boomshanka/Studienarbeit/doku/oszi/15-05-11/README

11. Mai 15: Auswertung Signale von Empfänger (Endplatine)

1: Erster OP, verstärkt Signal mit Faktor ~100
2: Ausgang und Eingang, Tiefpasswirkung und hohe Verstärkung wird sichtbar
