boomshanka/Studienarbeit/doku/oszi/15-04-16/README.txt

1: Laufzeitmessung. Channel 2 ist Sender, Channel 1 das empfangene Signal (hinter Transistor)
2: Signal von Push-Pull Ausgangsstufe. Zu schmal und Low-Pegel wird nicht sauber gehalten. Erster Puls ist doppelt so lang wie sein sollte.
3: Selbes Signal, erster Puls nicht verdoppelt.
4: Prototyp-Platine von unten
