boomshanka/Studienarbeit/doku/content/02_uebersicht.tex

%!TEX root = ../dokumentation.tex

% Kapitel als Übersicht des Projekts
% Inhalt: Zielsetzung, Entiwcklung/Umsetzung, Hardware, Architektur, Tools

\chapter{Projektübersicht}

%\section{Ziel}
Das Ziel des Projektes ist es, die Position eines Objektes mithilfe von Ultraschallsensoren zu messen. Dabei reicht die Position auf einer Fläche, sie muss daher nur zweidimensional bestimmt werden. Das Ergebnis soll anschließend auf einem Bildschirm visualisiert werden.\\
Ein erstes Zwischenergebnis sollte mit der Abstandsmessung einer einzelnen Sensorplatine erreicht werden. Diese Aufgabe umfasst bereits alle physikalische Prinzipien, die zur Positionsbestimmung genutzt werden. Die Ergebnisse der Messungen können daraufhin verwendet werden, um mögliche Probleme zu beseitigen und die Schaltungen zu optimieren. Sobald die Abstandsmessung zuverlässig funktioniert, kann das endgültige System darauf aufgebaut werden, sodass weitere Probleme ausschließlich durch die Architektur der Lösung hervorgerufen werden können und deshalb einfach zu identifizieren sind.

\section{Architektur} % Hier wird auch die Hardware beschrieben
Für die Positionsbestimmung werden drei Sender und Empfänger verwendet, sodass nicht nur die Position, sondern auch die Größe des Objekts bestimmbar ist. Jeweils einer ist auf einer Platine verbaut, auf der sich zusätzlich Schaltungen für die Signalverarbeitung und ein Mikrocontroller befinden. Die drei Platinen werden so angeordnet, dass sie Objekte in ihrer Mitte erkennen können. Sie sind mit einem Einplatinen-Computer verbunden, mit dem die Mikrocontroller über einen \ac{TWI}-Bus kommunizieren können. Zwischen dem Computer und den Sensorplatinen befindet sich eine Verteiler-Platine, an der die Stromversorgung eingesteckt wird und die Leitungen von Computer zu Platinen entsprechend verkabelt sind.
Zur Verbindung untereinander werden Flachbandkabel verwendet. Die Verteiler-Platine besitzt zusätzlich einen Steckplatz mit einer Standard-\ac{ISP}-Pinbelegung, mit dem die Mikrocontroller direkt vom Einplatinen-Computer beschrieben werden können.\\
% Bild Architektursübersicht
\begin{figure}[H]
\centering
\begin{tikzpicture}
%\filldraw[fill=black!20, draw=black] (0,0) -- (10,0) -- (10,5) -- (0,5) -- (0,0);

% Positionen der Platinen
\coordinate (s1) at (0, 0);
\coordinate (s2) at (3.3, 5.2);
\coordinate (s3) at (-3.3, 5.2);
\coordinate (com) at (-6.5, -1);
\coordinate (dis) at (-7, 3);
\coordinate (ver) at (-4, -1);
\coordinate (ob) at (-0.5, 3.5);

% Verbindungen
% Computer-Verteiler
\draw (com) -- (ver);
% Verteiler-Sensor1
\draw (ver) -- (0,-1);
% Verteiler-Sensor2
\draw (ver) |- (0,-1.7) -| ($(s2) + (1,0)$);
% Verteiler-Sensor3
\draw (ver) |- (s3);
% Computer-Bildschirm
\draw (com) |- ($(dis) + (0,-1.1)$);

% Platine 1
\begin{scope}[shift=(s1), rotate around={180:(s1)}]
	\filldraw[fill=red!60!black, draw=black] (-0.5,0) rectangle (0.5, 1.5);
	\fill[fill=black!80, draw=black] (0.15, 0) ellipse (0.12 and 0.08);
	\fill[fill=black!80, draw=black] (-0.15, 0) ellipse (0.12 and 0.08);
	\node[right] at (-0.7,1) {Sensorplatine 1};
\end{scope}

% Platine 2
\begin{scope}[shift=(s2), rotate around={300:(s2)}]
	\filldraw[fill=red!60!black, draw=black] (-0.5,0) rectangle (0.5, 1.5);
	\fill[fill=black!80, draw=black] (0.15, 0) ellipse (0.12 and 0.08);
		\fill[fill=black!80, draw=black] (-0.15, 0) ellipse (0.12 and 0.08);
	\node at (0, 3) {Sensorplatine 2};
\end{scope}

% Platine 3
\begin{scope}[shift=(s3), rotate around={60:(s3)}]
	\filldraw[fill=red!60!black, draw=black] (-0.5,0) rectangle (0.5, 1.5);
	\fill[fill=black!80, draw=black] (0.15, 0) ellipse (0.12 and 0.08);
		\fill[fill=black!80, draw=black] (-0.15, 0) ellipse (0.12 and 0.08);
	\node at (0, 3) {Sensorplatine 3};
\end{scope}

% Objekt
\filldraw[fill=green!50, draw=black] (ob) circle (0.7);
\node at (ob) {Objekt};

% Verteilerplatine
\begin{scope}[shift=(ver)]
	\filldraw[fill=brown!70, draw=black] (-0.25, -0.5) rectangle (0.25, 0.5);
	\node[below right] at (0, -0.7) {Verteilerplatine};
\end{scope}

% Raspberry PI
\begin{scope}[shift=(com)]
	\filldraw[fill=blue!70!black!70!white, draw=black] (-0.5, -0.75) rectangle (0.5, 0.75);
	\node[below] at (0, -0.75) {Computer};
\end{scope}

% Bildschirm
\begin{scope}[shift=(dis)]
	\filldraw[fill=white!70!black, draw=black] (-0.15, 0) rectangle (0.15, -1.4);
	\filldraw[fill=white!70!black, draw=black] (-1, -0.8) rectangle (1, 0.8);
	\filldraw[fill=white, draw=black] (-0.8, -0.6) rectangle (0.8, 0.6);
	\node[above] at (0, 0.9) {Bildschirm};
\end{scope}

\end{tikzpicture}
\caption{Schema der Architektur} \label{fig:ARCH}
\end{figure}

\subsection{Mikrocontroller}
Die Mikrocontroller auf den Sensorplatinen erfüllen folgende Zwecke:
\begin{itemize}
	\item Ansteuerung der Ultraschallsender
	\item Signal am Empfänger detektieren
	\item Laufzeitmessung durchführen
	\item Status über LEDs anzeigen
	\item Schnittstelle nach außen über das \ac{TWI} bereitstellen
\end{itemize}
Verwendet wird dafür der AVR-Mikrocontroller \textit{ATmega8} von Atmel. Die Controller aus der AVR-Familie sind weit verbreitet und besitzen eine 8-Bit Architektur mit einem \ac{RISC}-Befehlssatz. Sie sind günstig, einfach zu handhaben, besitzen eine übersichtliche innere Struktur und es gibt eine Vielzahl an Software und Tools, um mit ihnen zu arbeiten. Die Mikrocontroller bieten neben einfachen digitalen Input-/Output-Pins auch zusätzliche Hardwarefunktionen, wie z.B. Analog-Digital-Wandler, \ac{TWI}- und andere serielle Schnittstellen, Timer, verschiedenste Hardware-Interrupts und vieles mehr. \cite{datasheet:atmega}\\
Das Programm für die oben genannten Funktionen läuft als Firmware direkt auf der Hardware und ist in C geschrieben.

\subsection{Computer}
Der Einplatinen-Computer hat folgende Aufgaben:
\begin{itemize}
	\item Das Timing der Messungen kontrollieren
	\item Messergebnisse sammeln und auswerten
	\item Berechnete Position darstellen
	\item Eine \ac{GUI} bereitstellen %TODO: Ein/Eine?
\end{itemize}
Für diesen Zweck wird ein \textit{Raspberry PI} verwendet. Er besitzt ein \ac{GPIO}-Interface, mit dem die Mikrocontroller gesteuert werden können, sowie ein \ac{HDMI}-Ausgang für die Visualisierung auf einem Bildschirm. Auf dem Computer läuft das Betriebssystem \textit{Archlinux}, welches speziell für die mobilen \textit{ARM}-Prozessoren angepasst wurde.\footnote{\url{http://archlinuxarm.org/}}

\section{Entwicklung}
Es gibt bereits eine Vielzahl von fertigen Ultraschallmodulen zu kaufen, die mit relativ wenig Aufwand ansteuerbar und verwendbar sind. In diesem Projekt werden jedoch einfache Ultraschall-Sender und -Empfänger verwendet, sodass die dazugehörigen Schaltungen selbst erstellt werden konnten. Zudem mussten weitere Komponenten entwickelt werden, um das gesamte System lauffähig zu machen:
\begin{description}
	\item[Die Sensorplatine] mit den Komponenten:
	\begin{itemize}
		\item Sendeverstärker-Schaltung.
		\item Empfängerschaltung.
		\item Firmware für den Mikrocontroller.
	\end{itemize}
	\item[Die Verteilerplatine] mit den Komponenten:
	\begin{itemize}
		\item Bidirektionale \ac{TWI}-Spannungswandlung zwischen $3.3V$ (Raspberry Pi) und $5V$ (AVR-Mikrocontroller).
		\item Die \ac{ISP}-Schnittstelle.
		\item Verkabelung und Stromversorgung.
	\end{itemize}
	\item[Die Schnittstelle] zwischen Controllern und Computer:
	\begin{itemize}
		\item Das Protokoll, das auf dem \ac{TWI} aufsetzt.
		\item Implementierung des Interfaces in der Firmware und auf dem Computer.
	\end{itemize}
	\item[Die Software] für den Raspberry Pi:
	\begin{itemize}
		\item Die grafische Oberfläche.
		\item Ansteuerung der Platinen.
		\item Ablauf und Timing der Messungen.
	\end{itemize}
\end{description}

\section{Verwendete Tools}
Für die Entwicklung der Schaltungen sind einige Programme zum Einsatz gekommen. Damit lassen sich die Funktionalität überprüfen, Frequenzgänge berechnen und es können Platinenentwürfe und Schaltpläne entworfen werden. Die wichtigsten Tools für dieses Projekt waren folgende:
\begin{description}
	\item[KiCAD] ist ein open-source Programm, mit dem modulare Schaltpläne gezeichnet werden können, woraus sich anschließend CAD-Modelle einer Platine erstellen lassen. Das Programm wird maßgeblich am \textit{CERN} entwickelt und unterstützt viele zusätzliche Funktionen. So kann z.B. eine Netzliste für die \textit{SPICE}-Engine erstellt werden, mit der die Schaltungen simuliert werden können.\footnote{\url{http://www.kicad-pcb.org/}}
	\item[LTspice] ist ein Tool von \textit{Linear Technology} um analoge und digitale Schaltungen zu simulieren, insbesondere mit den firmeneigenen Operationsverstärkern. Das Programm basiert auf dem Simulator \textit{SPICE} und besitzt einen eigenen Schaltungseditor.\footnote{\url{http://www.linear.com/designtools/software/\#LTspice}}
	\item[AktivFilter] ist ein Tool, um Frequenzfilter mit Operationsverstärkern zu entwerfen. Aus einigen Vorgaben berechnet das Programm ein Bode-Diagramm, dimensioniert die Bauteile und stellt einen Schaltplan zur Verfügung.\footnote{\url{http://www.softwaredidaktik.de/filter/}}
\end{description}
