boomshanka/Studienarbeit/doku/ads/deckblatt.tex

%!TEX root = ../dokumentation.tex

\begin{titlepage}
	\begin{longtable}{p{8.2cm} p{5.4cm}}
%		{\raisebox{\ht\strutbox-\totalheight}{\includegraphics{images/firma-deckblatt.png}}} &
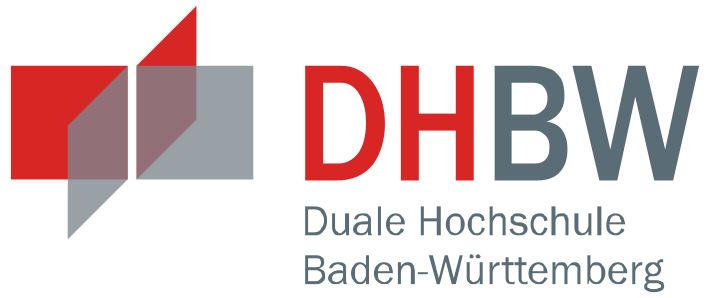
[picture p21: doku/images/dhbw.png]
		{\raisebox{\ht\strutbox-\totalheight}{}}
	\end{longtable}
	\enlargethispage{20mm}
	\begin{center}
		\vspace*{12mm}	{\LARGE\bf \titel }\\
		\vspace*{12mm}	{\large\bf \arbeit}\\
		\vspace*{12mm}	\langdeckblattabschlusshinleitung\\
		\vspace*{3mm}		{\bf \abschluss}\\
    \vspace*{12mm}	\langartikelstudiengang{} \studiengang\\
    \vspace*{3mm}		\langanderdh{} \dhbw\\
		\vspace*{12mm}	\langvon\\
		\vspace*{3mm}		{\large\bf \autor}\\
		\vspace*{12mm}	\datumAbgabe\\
	\end{center}
	\vfill
	\begin{spacing}{1.2}
	\begin{tabbing}
		mmmmmmmmmmmmmmmmmmmmmmmmmm             \= \kill
%		\textbf{\langdbbearbeitungszeit}       \>  \zeitraum\\
		\textbf{\langdbkurs}  \>  \kurs\\
%		\textbf{\langdbfirma}                  \>  \firma, \firmenort\\
		\textbf{\langdbgutachter, \langdbbetreuer}               \>  \betreuer\\
%		\textbf{\langdbgutachter}              \>  \gutachter
	\end{tabbing}
	\end{spacing}
\end{titlepage}
