boomshanka/Studienarbeit/doku/ads/erklaerung.tex

%!TEX root = ../dokumentation.tex

\thispagestyle{empty}

\section*{\langerklaerung}
% http://www.se.dhbw-mannheim.de/fileadmin/ms/wi/dl_swm/dhbw-ma-wi-organisation-bewertung-bachelorarbeit-v2-00.pdf
\vspace*{2em}

\iflang{de}{%
Wir erklären hiermit ehrenwörtlich: \\
\begin{enumerate}
\item dass wir unsere {\arbeit} mit dem Thema
{\itshape \titel } ohne fremde Hilfe angefertigt haben;
\item dass wir die Übernahme wörtlicher Zitate aus der Literatur sowie die Verwendung der Gedanken
anderer Autoren an den entsprechenden Stellen innerhalb der Arbeit gekennzeichnet haben;
\item dass wir unsere {\arbeit} bei keiner anderen Prüfung vorgelegt haben;
\item dass die eingereichte elektronische Fassung exakt mit der eingereichten schriftlichen Fassung
übereinstimmt.
\end{enumerate}

Wir sind uns bewusst, dass eine falsche Erklärung rechtliche Folgen haben wird.
}

\iflang{en}{%
Unless otherwise indicated in the text or references, or acknowledged
above, this thesis is entirely the product of my own scholarly work. This
thesis has not been submitted either in whole or part, for a degree at this
or any other university or institution. This is to certify that the printed
version is equivalent to the submitted electronic one.
}

\vspace{3em}

\abgabeort, \datumAbgabe
\vspace{4em}

\autor
