boomshanka/Studienarbeit/doku/oszi/15-04-30/README

1: Ansteuersignal und Ausgang der Gegentaktstufe (mit angeschlossenen Sender). Flanken gut, Oberwellen sichtbar. Besser gehts nicht mehr..
