boomshanka/Studienarbeit/doku/dokumentation.tex

%%**************************************************************
%% Vorlage fuer Bachelorarbeiten (o.ä.) der DHBW
%%
%% Autor: Tobias Dreher, Yves Fischer
%% Datum: 06.07.2011
%%
%% Autor: Michael Gruben
%% Datum: 15.05.2013
%%
%% Autor: Markus Barthel
%% Datum: 22.08.2014
%%**************************************************************

\input{ads/header}

\makeglossaries
\input{ads/glossary}

\begin{document}

	% Deckblatt
	\begin{spacing}{1}
		\input{ads/deckblatt}
	\end{spacing}
	\newpage

	\renewcommand{\thepage}{\Roman{page}}
	\setcounter{page}{1}

	% Sperrvermerk
%	\input{ads/sperrvermerk}
%	\newpage

	% Erklärung
	\input{ads/erklaerung}
	\newpage

	% Abstract
%	\input{ads/abstract}
%	\newpage

	\pagestyle{plain}

	% Inhaltsverzeichnis
	\begin{spacing}{1.1}
		\setcounter{tocdepth}{1}
		%für die Anzeige von Unterkapiteln im Inhaltsverzeichnis
		%\setcounter{tocdepth}{2}
		\tableofcontents
	\end{spacing}
	\newpage

	\renewcommand{\thepage}{\arabic{page}}
	\setcounter{page}{1}

	% Inhalt
	\input{content/01_einfuehrung.tex}
	\input{content/02_uebersicht.tex}
	\input{content/03_schaltungen.tex}
	\input{content/04_platinen.tex}
	\input{content/05_firmware.tex}
	\input{content/06_schnittstellenkommunikation.tex}
	\input{content/07_gui.tex}
%	\input{content/08_funktionstest.tex} % Messergebnisse, Genauigkeit, Zuverlässigkeit
	\input{content/09_inbetriebnahme.tex}
	\input{content/10_schluss.tex}

	% Anhang
	\clearpage
	\pagenumbering{roman}

	% Abbildungsverzeichnis
	\cleardoublepage
	\listoffigures

	%Tabellenverzeichnis
%	\cleardoublepage
%	\listoftables

	% Quellcodeverzeichnis
%	\cleardoublepage
%	\lstlistoflistings

	% Literaturverzeichnis
	\cleardoublepage
	\printbibliography

	% Abkürzungsverzeichnis
	\cleardoublepage
	\phantomsection \label{listofacs}
	\addcontentsline{toc}{chapter}{\langabkverz}
	\input{ads/acronyms}

	% Glossar
	\printglossary[style=altlist,title=\langglossar]
\end{document}
