boomshanka/Studienarbeit/doku/ads/header.tex

%!TEX root = ../dokumentation.tex

%
% Nahezu alle Einstellungen koennen hier getaetigt werden
%

\documentclass[%
	pdftex,
	oneside,			% Einseitiger Druck.
	12pt,				% Schriftgroesse
	parskip=half,		% Halbe Zeile Abstand zwischen Absätzen.
	headsepline,		% Linie nach Kopfzeile.
	footsepline,		% Linie vor Fusszeile.
	abstracton,			% Abstract Überschriften
	listof=totoc,
	toc=bibliography,
]{scrreprt}

% Einstellungen laden
\usepackage{xstring}
\usepackage[utf8]{inputenc}
\usepackage[T1]{fontenc}

\newcommand{\einstellung}[1]{%
  \expandafter\newcommand\csname #1\endcsname{}
  \expandafter\newcommand\csname setze#1\endcsname[1]{\expandafter\renewcommand\csname#1\endcsname{##1}}
}
\newcommand{\langstr}[1]{\einstellung{lang#1}}

\input{ads/einstellungen_liste} % verfügbare Einstellungen
\input{einstellungen} % lese Einstellungen

\input{lang/strings} % verfügbare Strings
\input{lang/\sprache} % Übersetzung einlesen

\usepackage[english, ngerman]{babel}
\iflang{de}{\selectlanguage{ngerman}} % Paket babel benutzt neue deutsche Rechtschreibung
\iflang{en}{\selectlanguage{english}} % Paket babel benutzt Englisch

%%%%%%% Package Includes %%%%%%%

\usepackage[margin=1in]{geometry}
\usepackage[activate]{microtype} %Zeilenumbruch und mehr
\usepackage[onehalfspacing]{setspace}
\usepackage{makeidx}
\usepackage[autostyle=true,german=quotes]{csquotes}
\usepackage{longtable}
\usepackage{graphicx}
\usepackage{xcolor} 	%xcolor für HTML-Notation
\usepackage{float}
\usepackage{array}
\usepackage{calc}		%zum Rechnen (Bildtabelle in Deckblatt)
\usepackage[right]{eurosym}
\usepackage{wrapfig}
\usepackage{pgffor} % für automatische Kapiteldateieinbindung
\usepackage[perpage, hang, multiple, stable]{footmisc}
\usepackage[printonlyused,footnote]{acronym}
\usepackage[nonumberlist,toc]{glossaries}
\usepackage{listings}

% eine Kommentarumgebung "k" (Handhabe mit \begin{k}<Kommentartext>\end{k},
% Kommentare werden rot gedruckt). Wird \% vor excludecomment{k} entfernt,
% werden keine Kommentare mehr gedruckt.
\usepackage{comment}
\specialcomment{k}{\begingroup\color{red}}{\endgroup}
%\excludecomment{k}

% TIKZ für Grafiken
\usepackage{tikz}
\usepackage{circuitikz}

\usetikzlibrary{calc}
\usetikzlibrary{shapes.geometric, arrows}

\tikzstyle{startstop} = [rectangle, rounded corners, minimum width=4.5cm, minimum height=1cm,text centered, draw=black, fill=red!30]
\tikzstyle{io} =		[trapezium, trapezium left angle=70, trapezium right angle=110, minimum width=4.5cm, minimum height=1cm, text centered, draw=black, fill=blue!30]
\tikzstyle{process} =	[rectangle, minimum width=4.5cm, minimum height=1cm, text centered, draw=black, fill=orange!30]
\tikzstyle{decision} =	[diamond, minimum width=4.5cm, minimum height=1cm, text centered, draw=black, fill=green!30]
\tikzstyle{arrow} =		[thick,->,>=stealth]

%%%%%% Configuration %%%%%

%% Anwenden der Einstellungen

\usepackage{\schriftart}
\ladefarben{}

% Titel, Autor und Datum
\title{\titel}
\author{\autor}
\date{\datum}

% PDF Einstellungen
\usepackage[%
	pdftitle={\titel},
	pdfauthor={\autor},
	pdfsubject={\arbeit},
	pdfcreator={pdflatex, LaTeX with KOMA-Script},
	pdfpagemode=UseOutlines, 		% Beim Oeffnen Inhaltsverzeichnis anzeigen
	pdfdisplaydoctitle=true, 		% Dokumenttitel statt Dateiname anzeigen.
	pdflang={\sprache}, 			% Sprache des Dokuments.
]{hyperref}

% (Farb-)einstellungen für die Links im PDF
\hypersetup{%
	colorlinks=true, 		% Aktivieren von farbigen Links im Dokument
	linkcolor=LinkColor, 	% Farbe festlegen
	citecolor=LinkColor,
	filecolor=LinkColor,
	menucolor=LinkColor,
	urlcolor=LinkColor,
	linktocpage=true, 		% Nicht der Text sondern die Seitenzahlen in Verzeichnissen klickbar
	bookmarksnumbered=true 	% Überschriftsnummerierung im PDF Inhalt anzeigen.
}
% Workaround um Fehler in Hyperref, muss hier stehen bleiben
\usepackage{bookmark} %nur ein latex-Durchlauf für die Aktualisierung von Verzeichnissen nötig

% Schriftart in Captions etwas kleiner
\addtokomafont{caption}{\small}

% Literaturverweise (sowohl deutsch als auch englisch)
\iflang{de}{%
\usepackage[
	backend=bibtex,		% empfohlen. Falls biber Probleme macht: bibtex
	bibwarn=true,
	bibencoding=utf8,	% wenn .bib in utf8, sonst ascii
	sortlocale=de_DE,
	style=numeric-comp	%Zitierstil. Siehe http://ctan.mirrorcatalogs.com/macros/latex/contrib/biblatex/doc/biblatex.pdf
]{biblatex}
}

\iflang{en}{%
\usepackage[
	backend=biber,		% empfohlen. Falls biber Probleme macht: bibtex
	bibwarn=true,
	bibencoding=utf8,	% wenn .bib in utf8, sonst ascii
	sortlocale=en_US,
	style=alphabetic	%Zitierstil. Siehe http://ctan.mirrorcatalogs.com/macros/latex/contrib/biblatex/doc/biblatex.pdf
]{biblatex}
}

\ladeliteratur{}

%%%%%% Additional settings %%%%%%

% Hurenkinder und Schusterjungen verhindern
% http://projekte.dante.de/DanteFAQ/Silbentrennung
\clubpenalty=10000
\widowpenalty=10000
\displaywidowpenalty=10000

% Bildpfad
\graphicspath{{images/}}

% Einige häufig verwendete Sprachen
\lstloadlanguages{PHP,Python,Java,C,C++,bash}
\listingsettings{}

\setlength{\tabcolsep}{\spaltenabstand}
\renewcommand{\arraystretch}{\zeilenabstand}

\usepackage{lscape}
