boomshanka/Studienarbeit/Datenblätter/PDIP.jpg

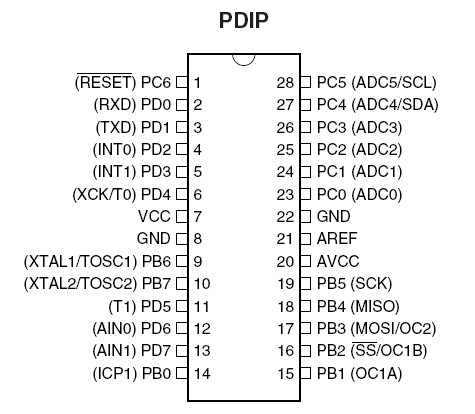
Datenblätter/PDIP.jpg
