boomshanka/Studienarbeit/doku/oszi/14-27-12/2_02.jpg

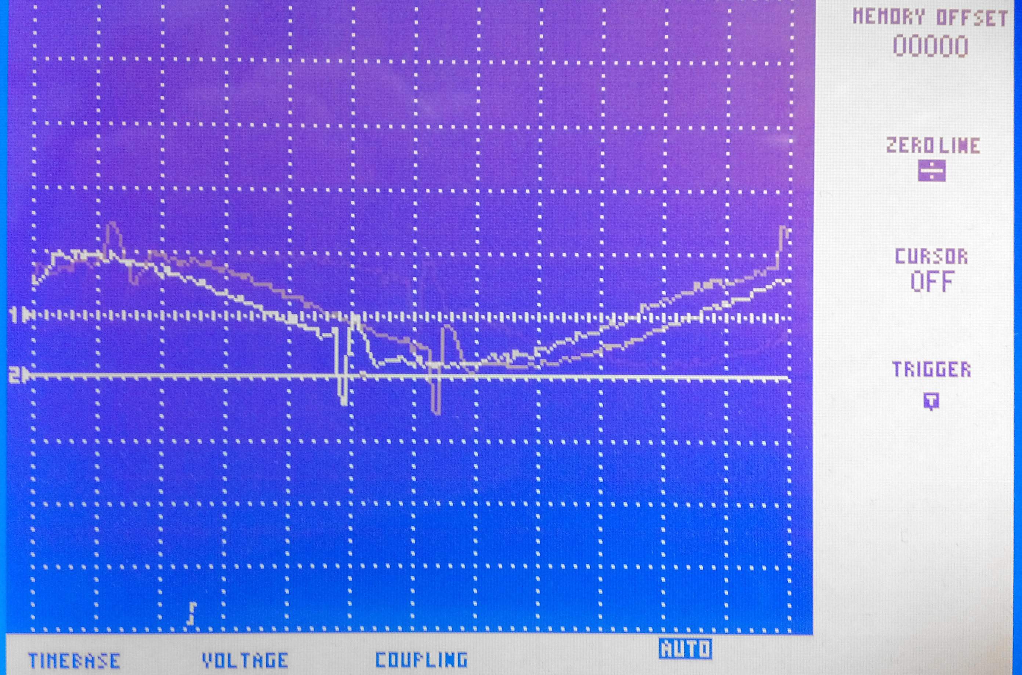
doku/oszi/14-27-12/2_02.jpg
