boomshanka/Studienarbeit/doku/oszi/15-04-01/1.jpg

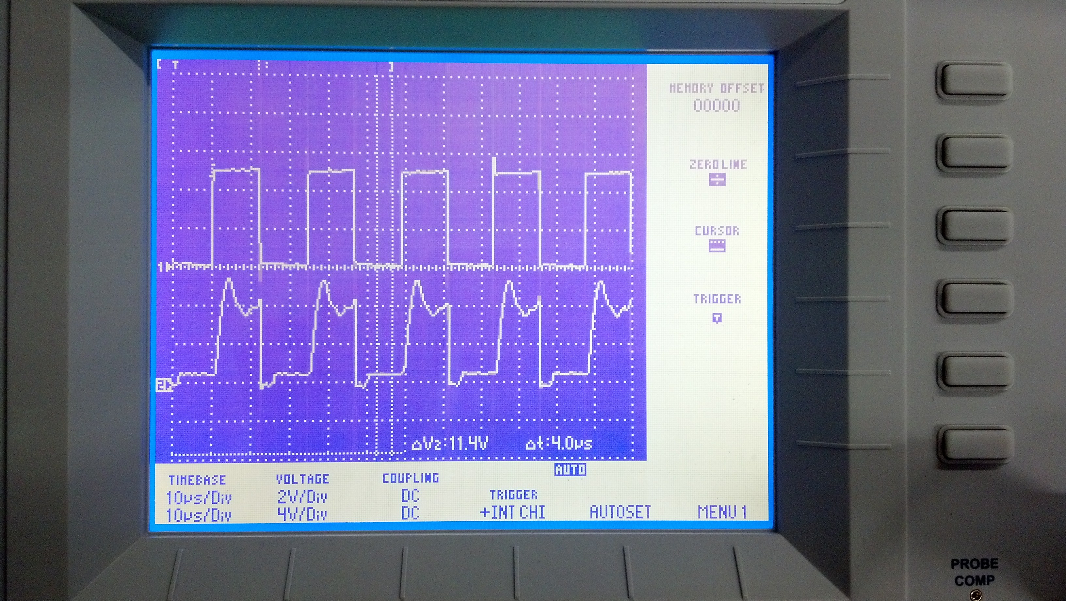
doku/oszi/15-04-01/1.jpg
