boomshanka/Studienarbeit/doku/oszi/15-04-01/1.png

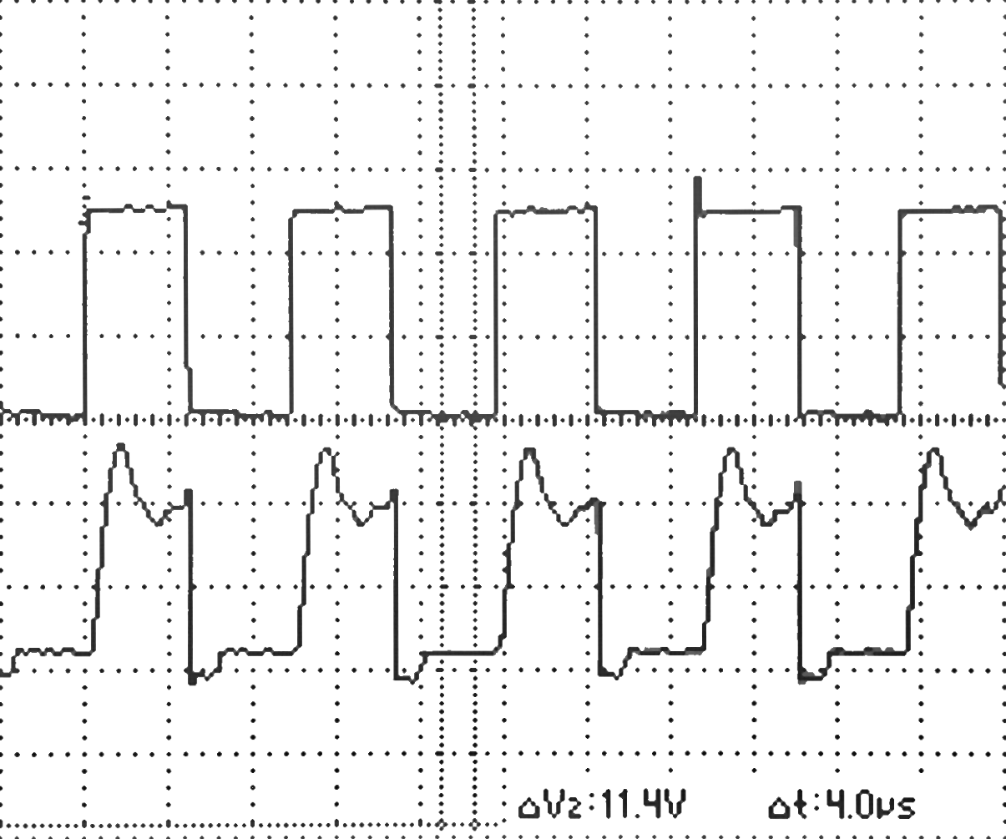
doku/oszi/15-04-01/1.png
