boomshanka/Studienarbeit/doku/oszi/15-04-01/2.jpg

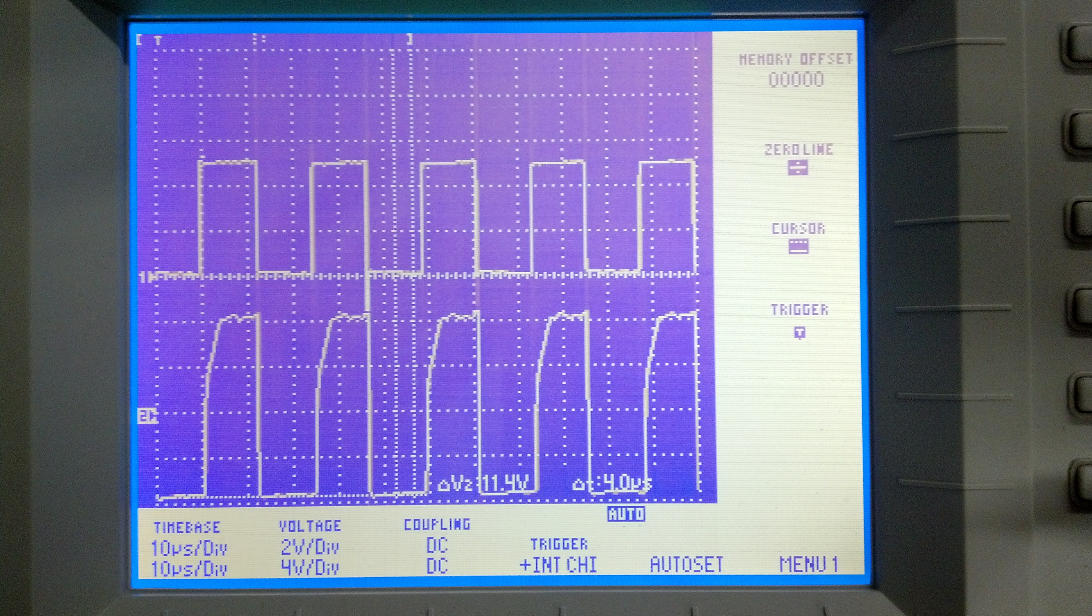
doku/oszi/15-04-01/2.jpg
