boomshanka/Studienarbeit/doku/oszi/15-04-01/2.png

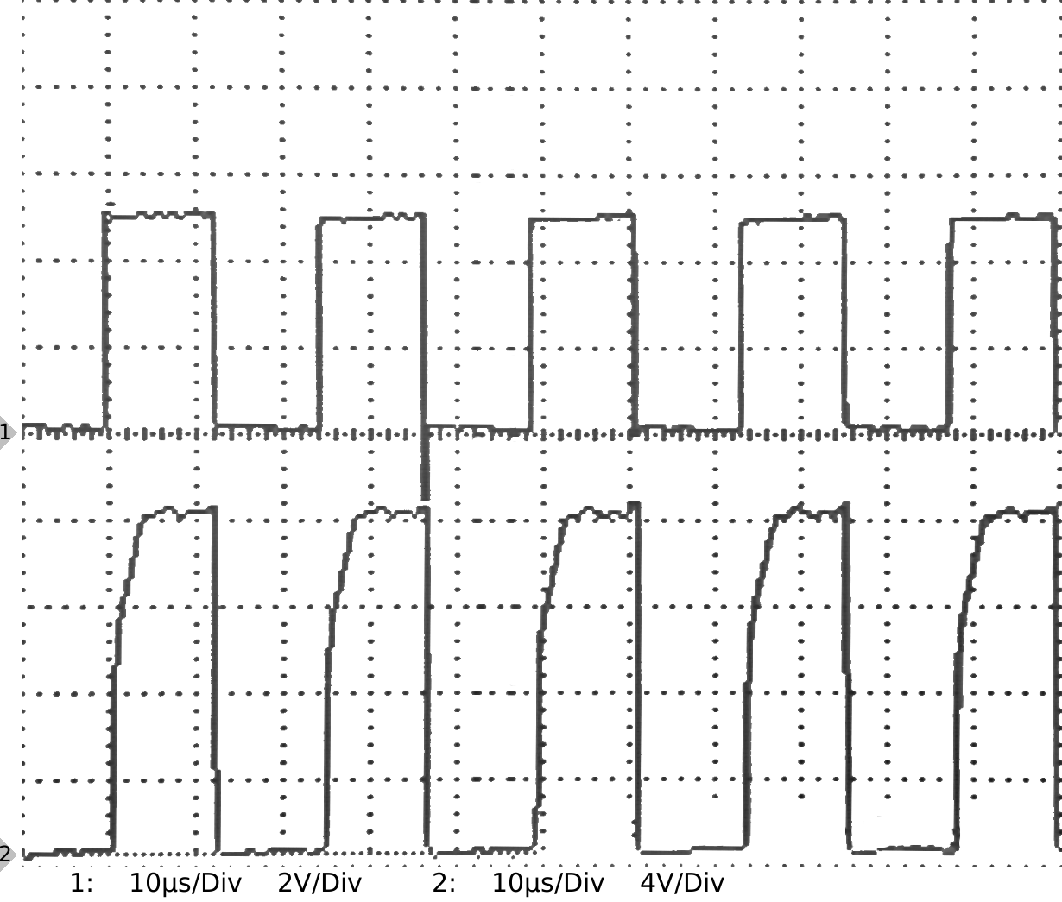
doku/oszi/15-04-01/2.png
