boomshanka/Studienarbeit/doku/oszi/15-04-01/3.jpg

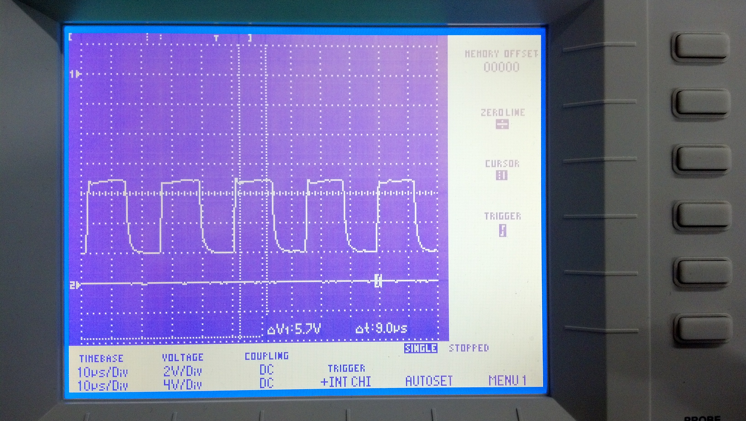
doku/oszi/15-04-01/3.jpg
