boomshanka/Studienarbeit/doku/oszi/15-04-01/3.png

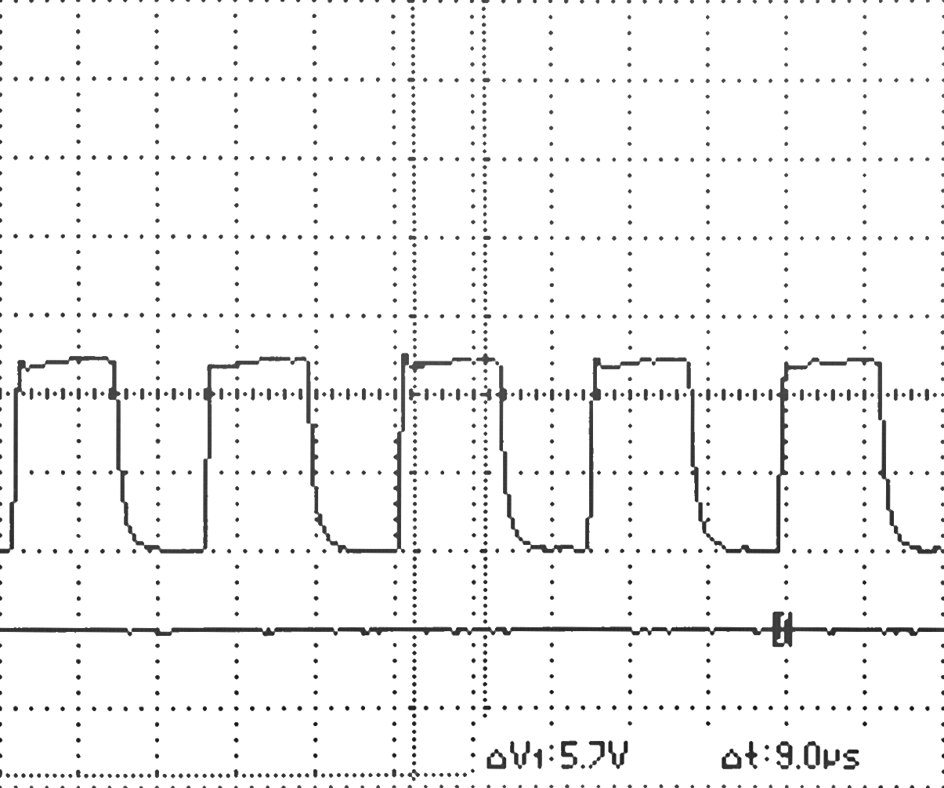
doku/oszi/15-04-01/3.png
