boomshanka/Studienarbeit/doku/oszi/15-04-01/4.jpg

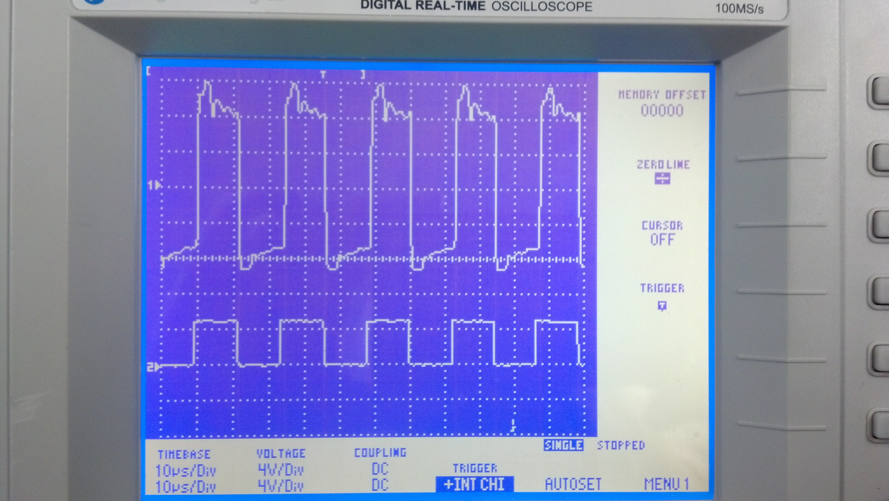
doku/oszi/15-04-01/4.jpg
