boomshanka/Studienarbeit/doku/oszi/15-04-16/1.jpg

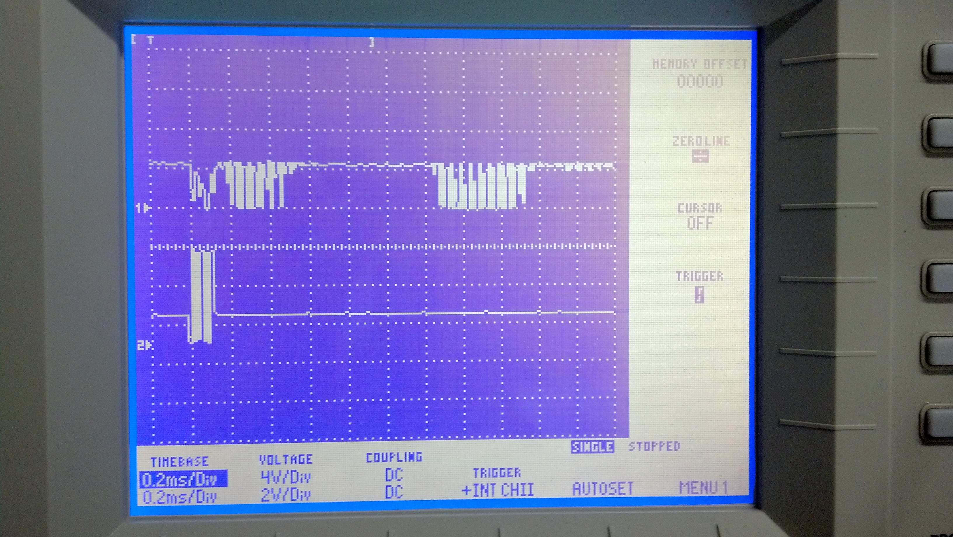
doku/oszi/15-04-16/1.jpg
