boomshanka/Studienarbeit/doku/oszi/15-04-16/1.png

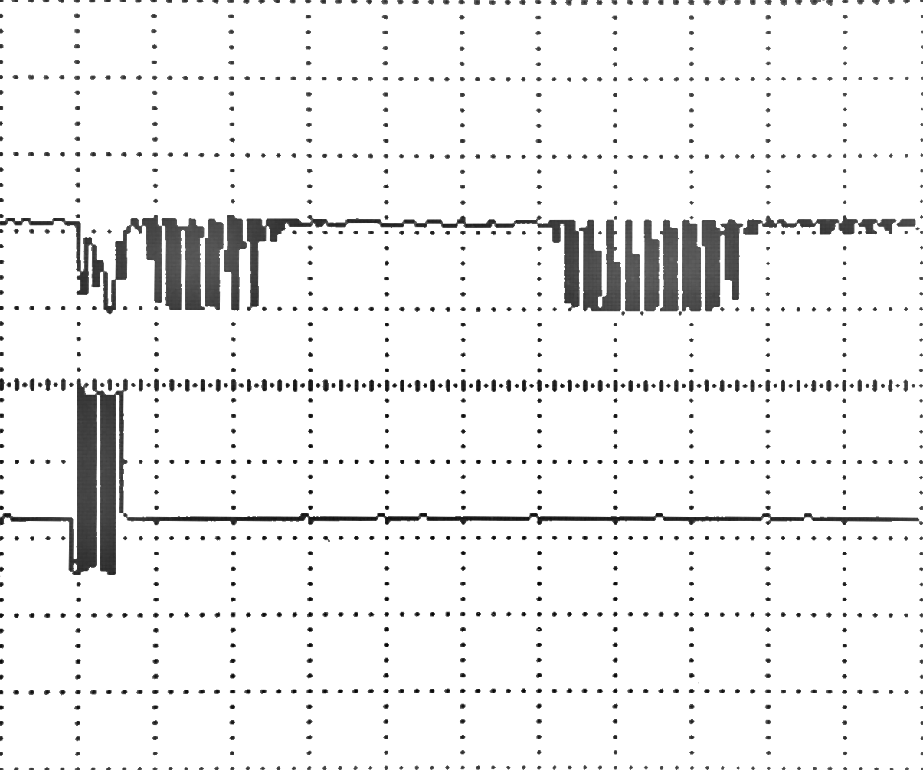
doku/oszi/15-04-16/1.png
