boomshanka/Studienarbeit/doku/oszi/15-04-16/2.jpg

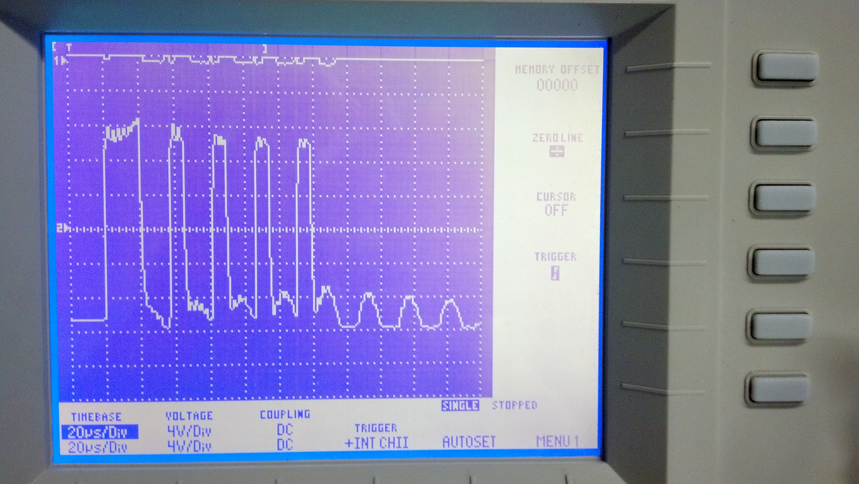
doku/oszi/15-04-16/2.jpg
