boomshanka/Studienarbeit/doku/oszi/15-04-16/2.png

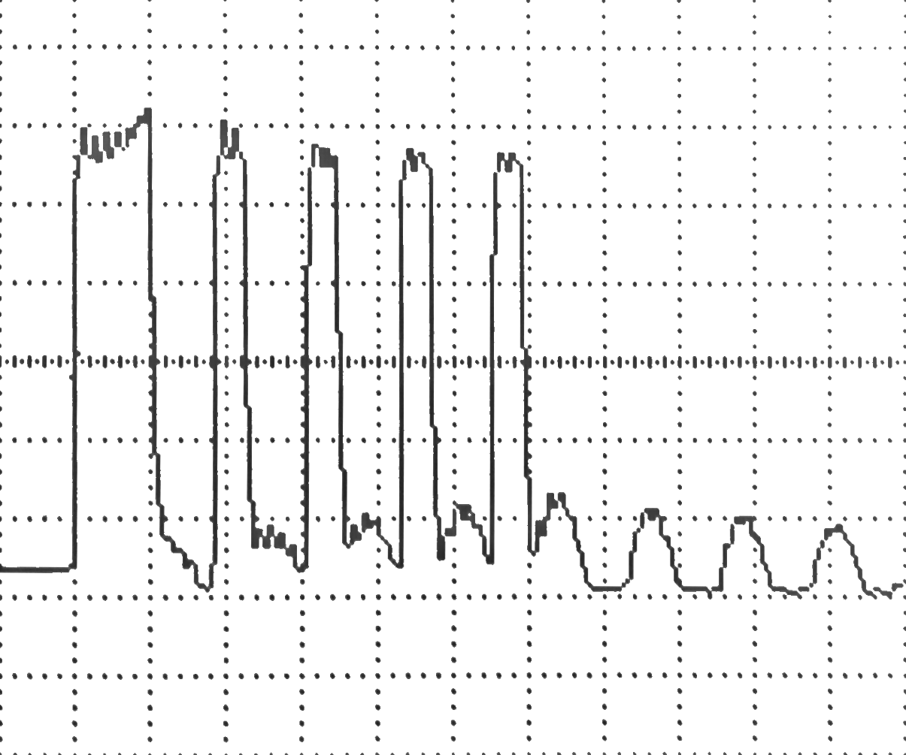
doku/oszi/15-04-16/2.png
