boomshanka/Studienarbeit/doku/oszi/15-04-16/3.jpg

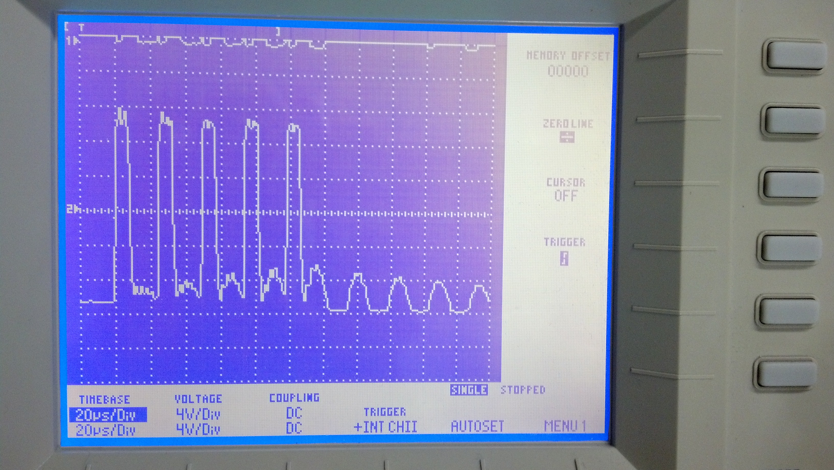
doku/oszi/15-04-16/3.jpg
