boomshanka/Studienarbeit/doku/oszi/15-04-16/3.png

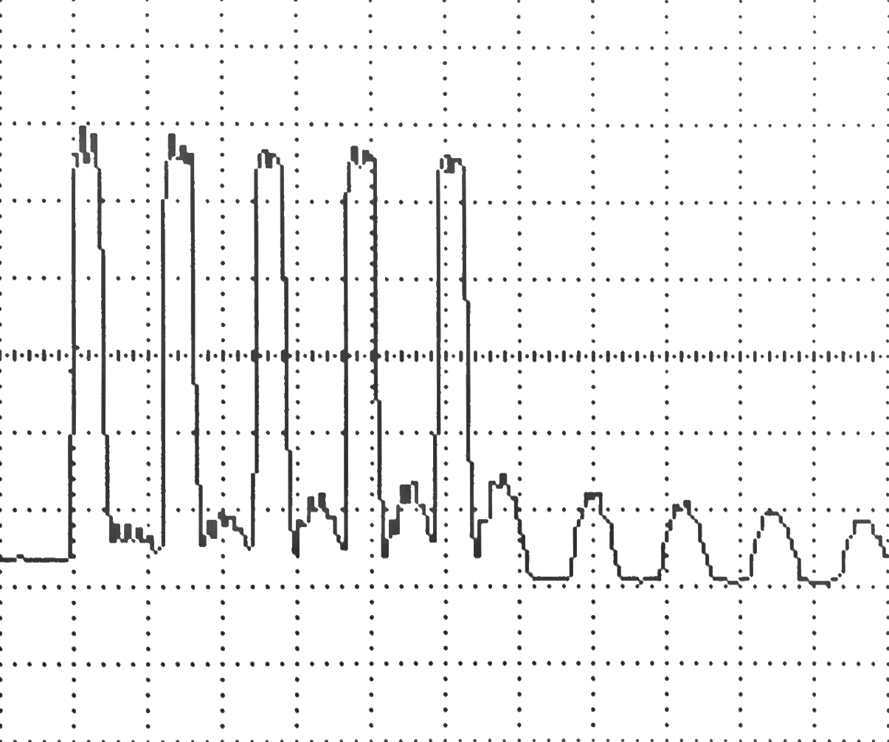
doku/oszi/15-04-16/3.png
