boomshanka/Studienarbeit/doku/oszi/15-04-16/4.jpg

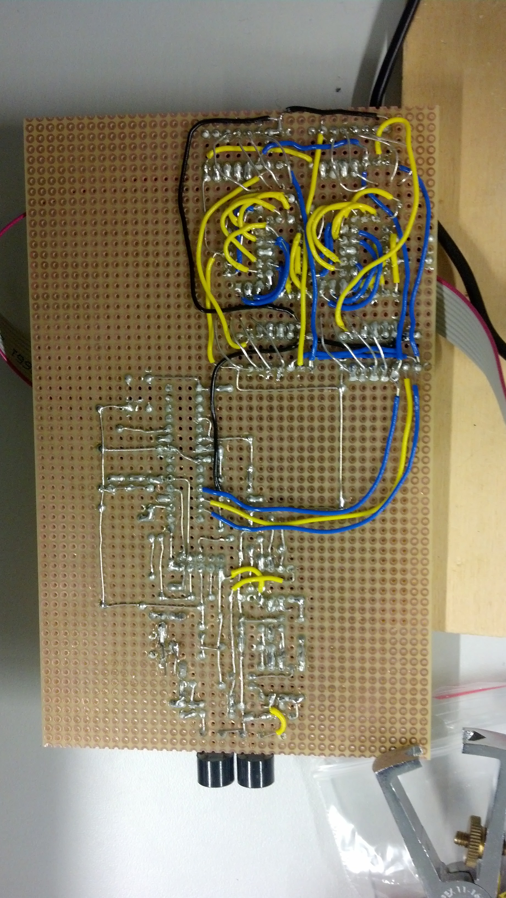
doku/oszi/15-04-16/4.jpg
