boomshanka/Studienarbeit/doku/oszi/15-04-23/1_01.jpg

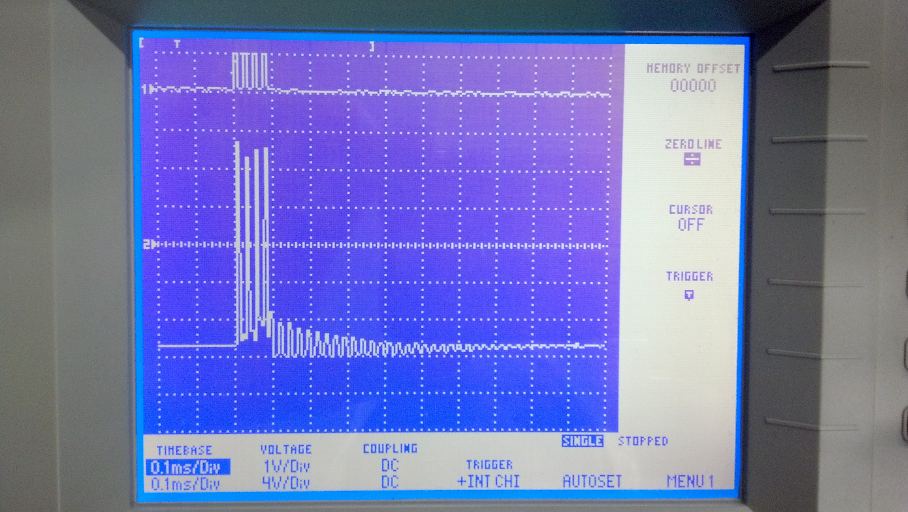
doku/oszi/15-04-23/1_01.jpg
