boomshanka/Studienarbeit/doku/oszi/15-04-23/1_02.jpg

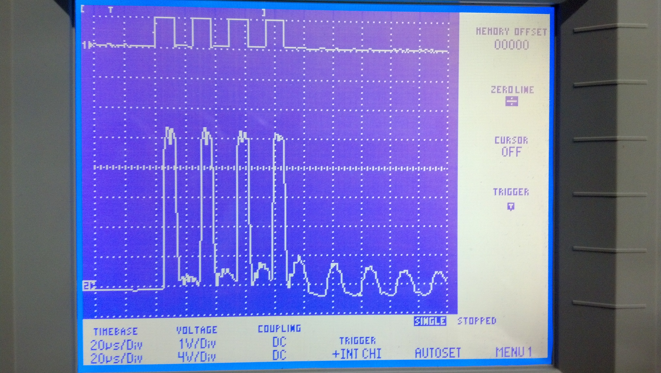
doku/oszi/15-04-23/1_02.jpg
