boomshanka/Studienarbeit/doku/oszi/15-04-23/1_02.png

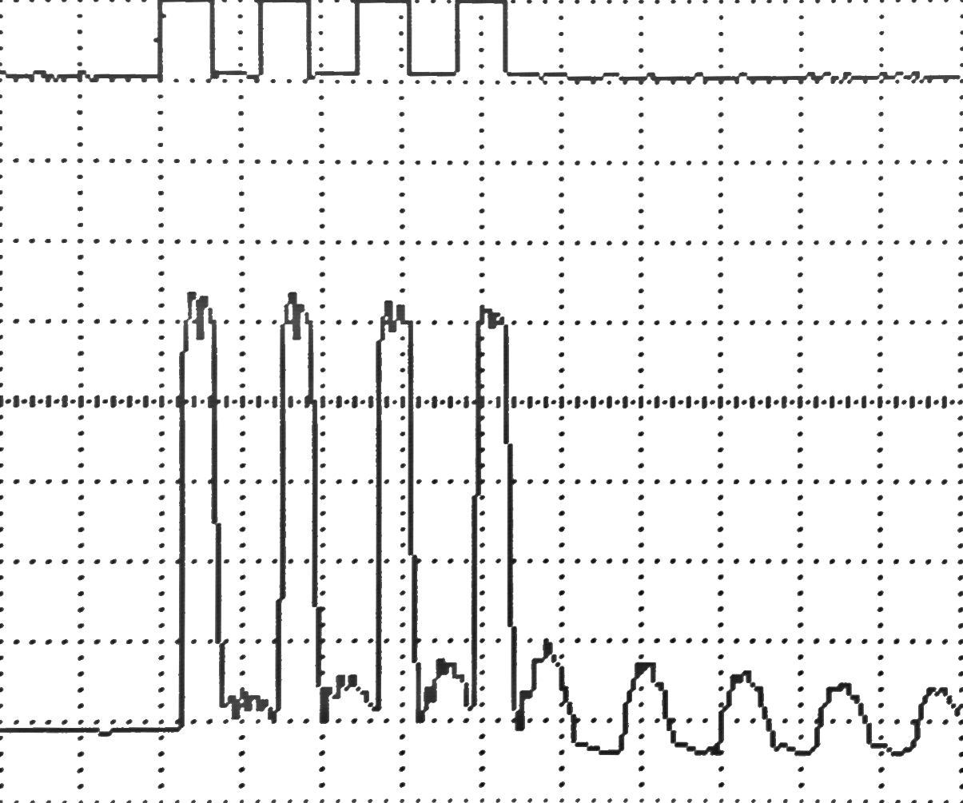
doku/oszi/15-04-23/1_02.png
