boomshanka/Studienarbeit/doku/oszi/15-04-23/2_01.jpg

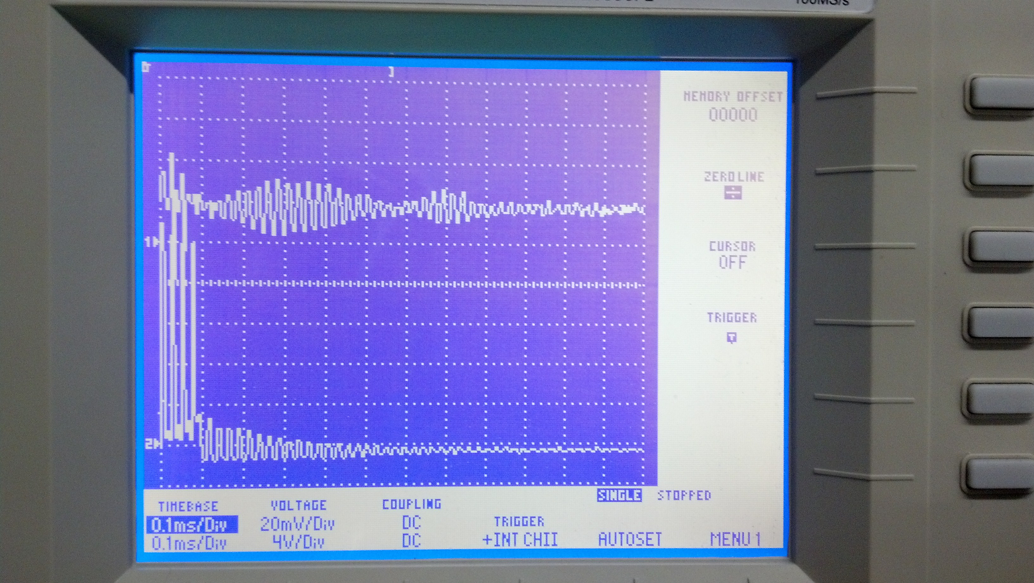
doku/oszi/15-04-23/2_01.jpg
