boomshanka/Studienarbeit/doku/oszi/15-04-23/3_03.jpg

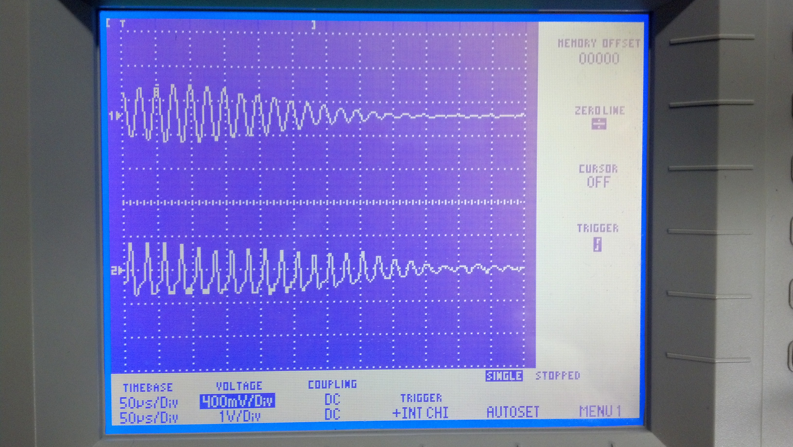
doku/oszi/15-04-23/3_03.jpg
