boomshanka/Studienarbeit/doku/oszi/15-04-23/4_01.jpg

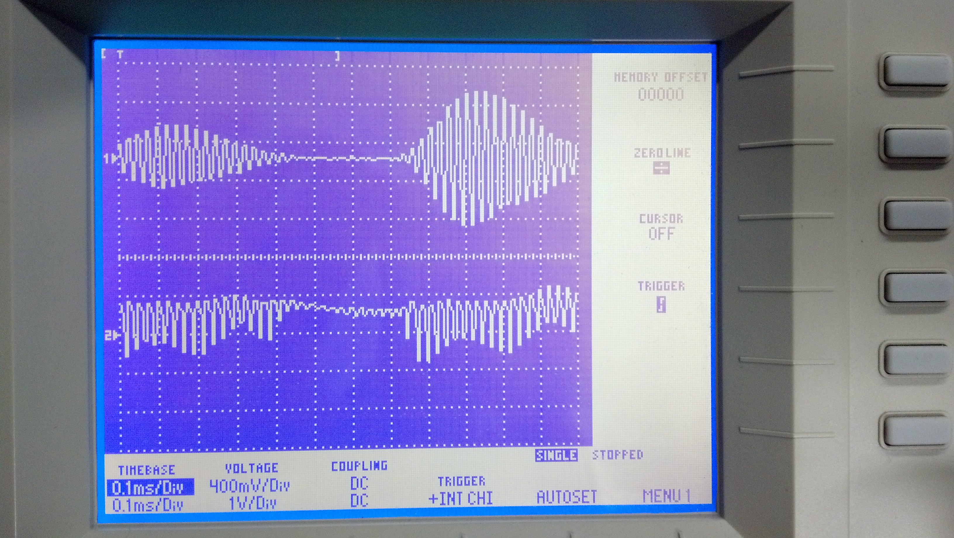
doku/oszi/15-04-23/4_01.jpg
