boomshanka/Studienarbeit/doku/oszi/15-04-23/4_01.png

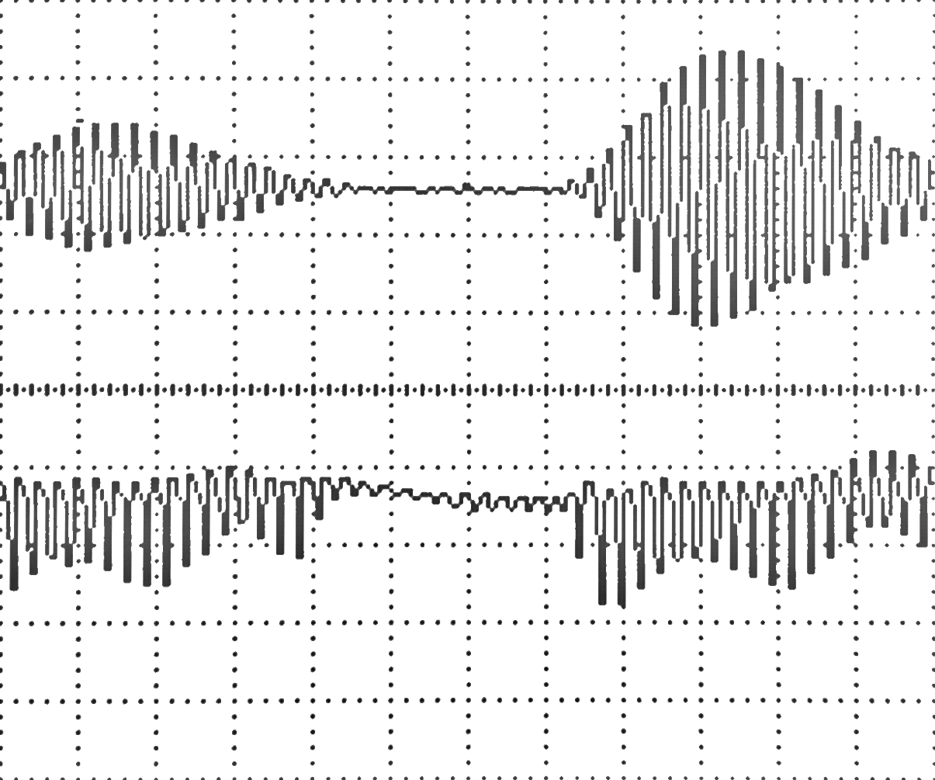
doku/oszi/15-04-23/4_01.png
