boomshanka/Studienarbeit/doku/oszi/15-04-23/4_02.jpg

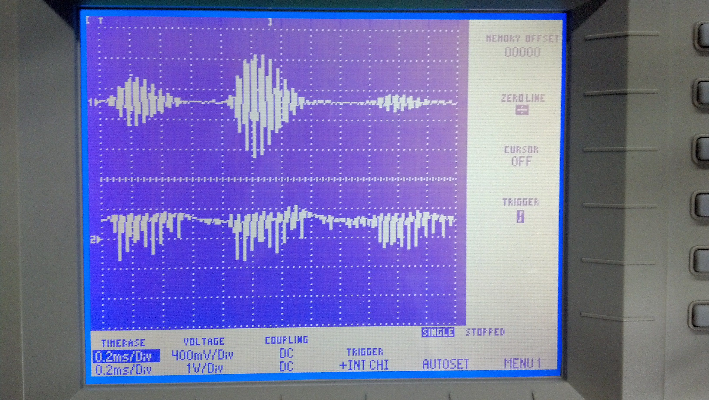
doku/oszi/15-04-23/4_02.jpg
