boomshanka/Studienarbeit/doku/oszi/15-04-23/4_02.png

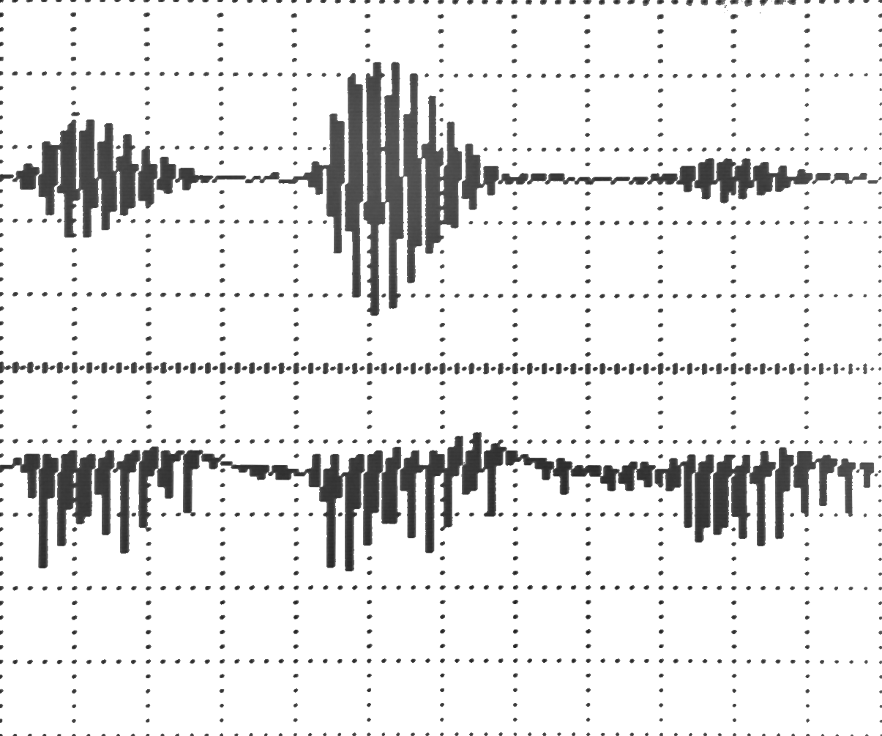
doku/oszi/15-04-23/4_02.png
