boomshanka/Studienarbeit/doku/oszi/15-04-23/4_03.jpg

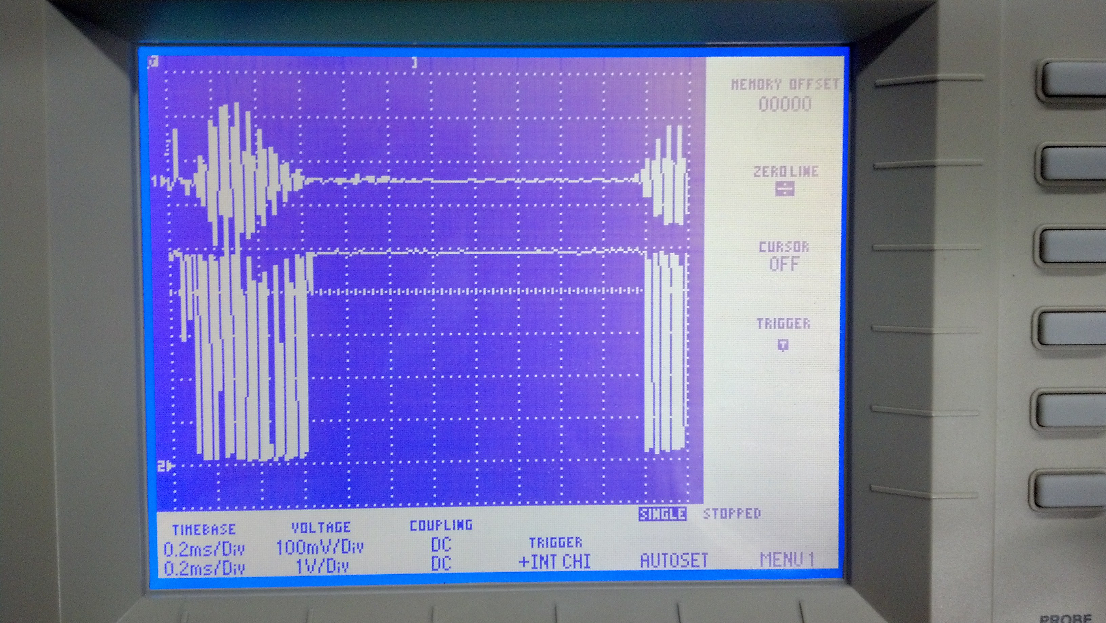
doku/oszi/15-04-23/4_03.jpg
