boomshanka/Studienarbeit/doku/oszi/15-04-23/4_04.jpg

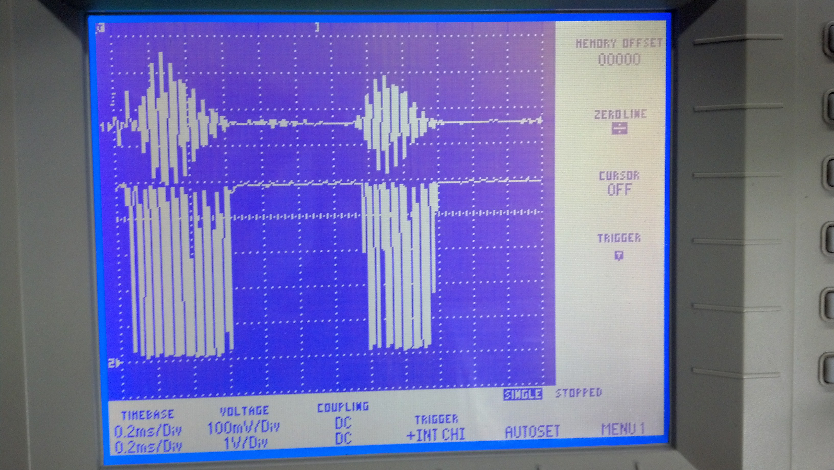
doku/oszi/15-04-23/4_04.jpg
