boomshanka/Studienarbeit/doku/oszi/15-04-23/4_04.png

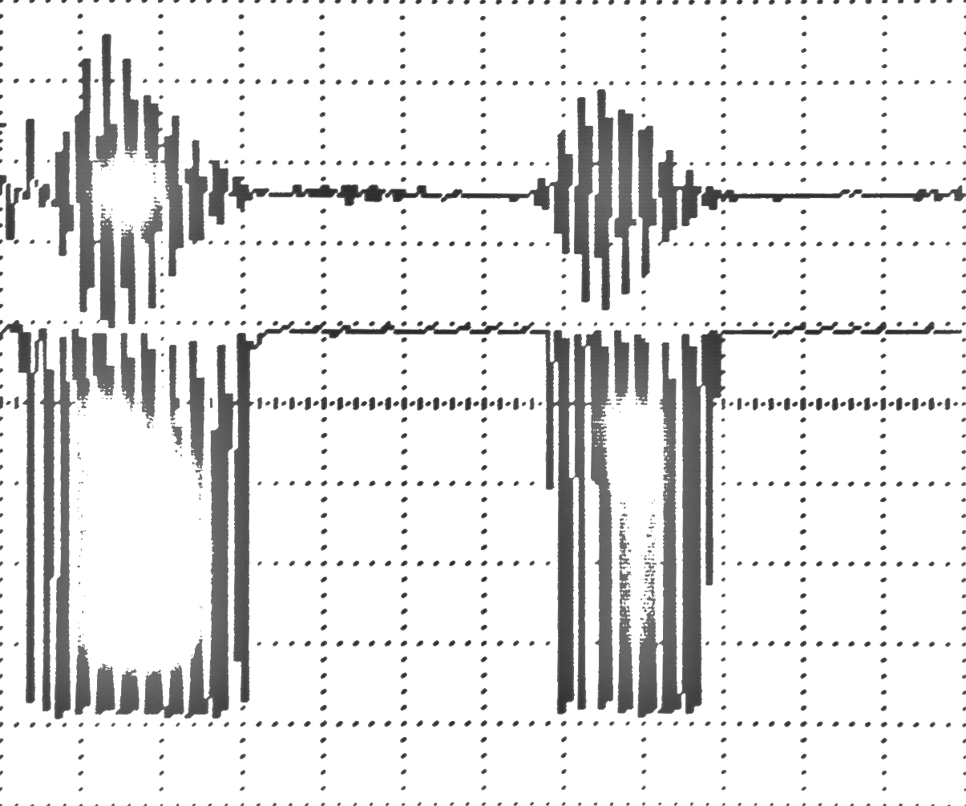
doku/oszi/15-04-23/4_04.png
