boomshanka/Studienarbeit/doku/oszi/15-04-30/1.jpg

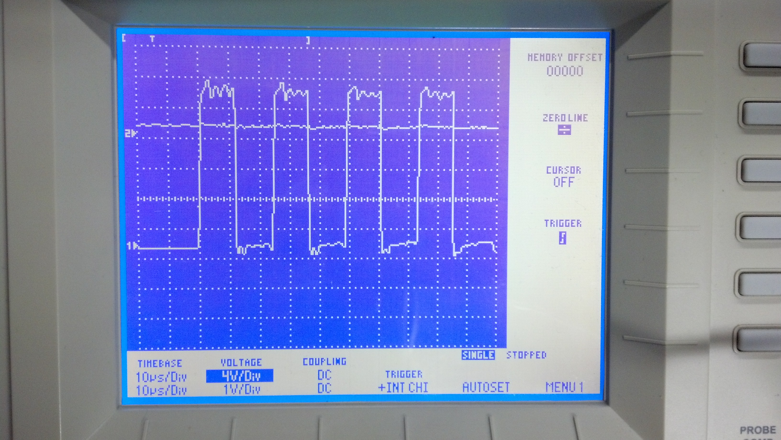
doku/oszi/15-04-30/1.jpg
