boomshanka/Studienarbeit/doku/oszi/15-04-30/1.png

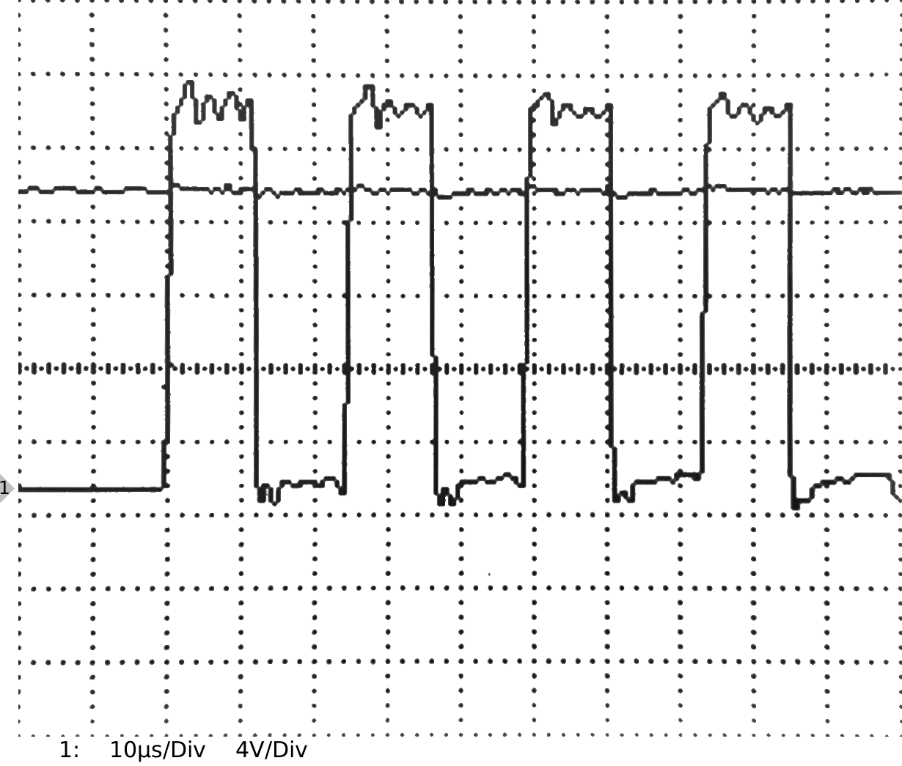
doku/oszi/15-04-30/1.png
