boomshanka/Studienarbeit/doku/oszi/15-05-04/1.jpg

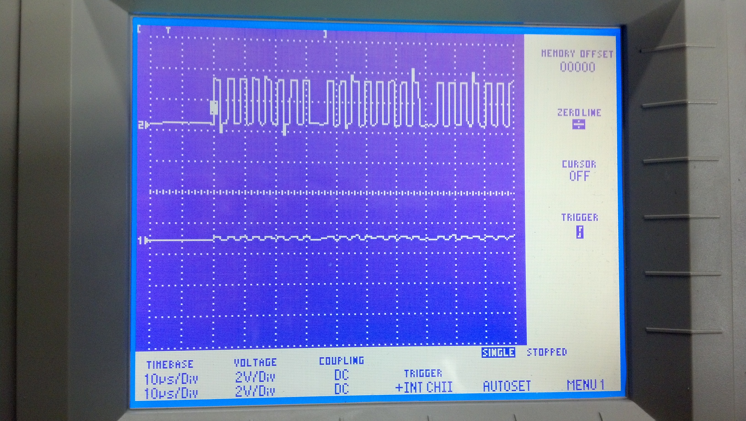
doku/oszi/15-05-04/1.jpg
