boomshanka/Studienarbeit/doku/oszi/15-05-04/1.png

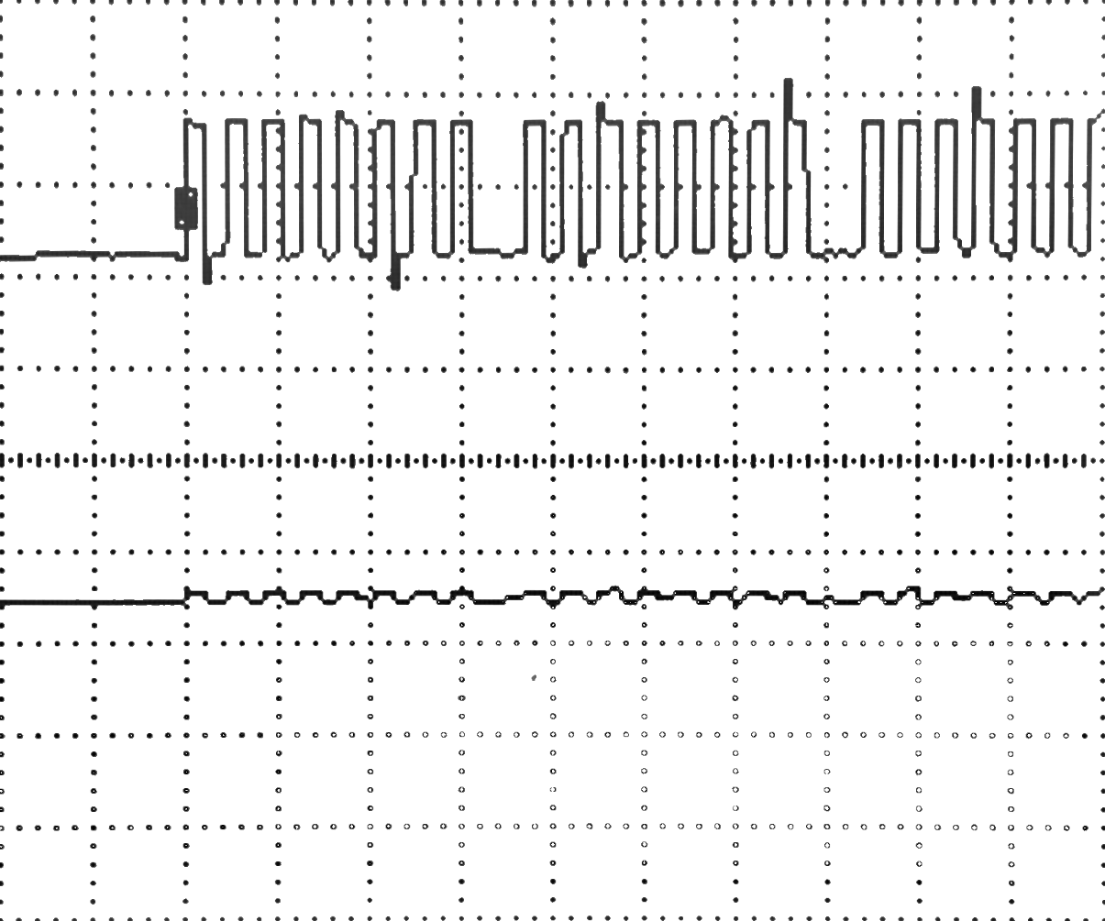
doku/oszi/15-05-04/1.png
