boomshanka/Studienarbeit/doku/oszi/15-05-04/2.jpg

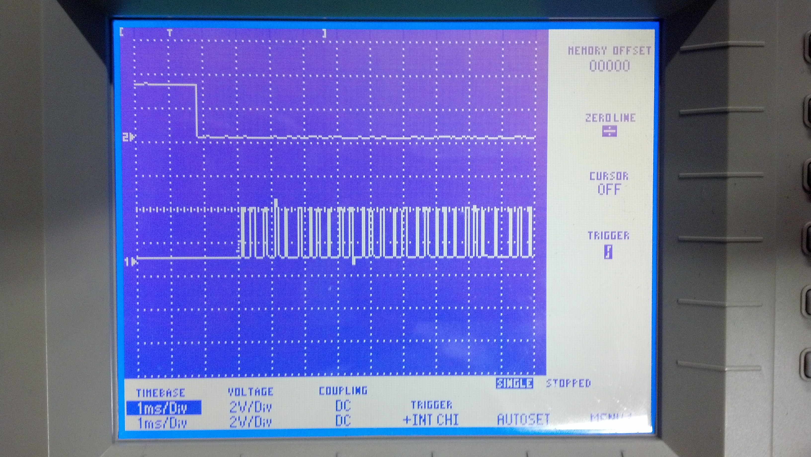
doku/oszi/15-05-04/2.jpg
