boomshanka/Studienarbeit/doku/oszi/15-05-04/2.png

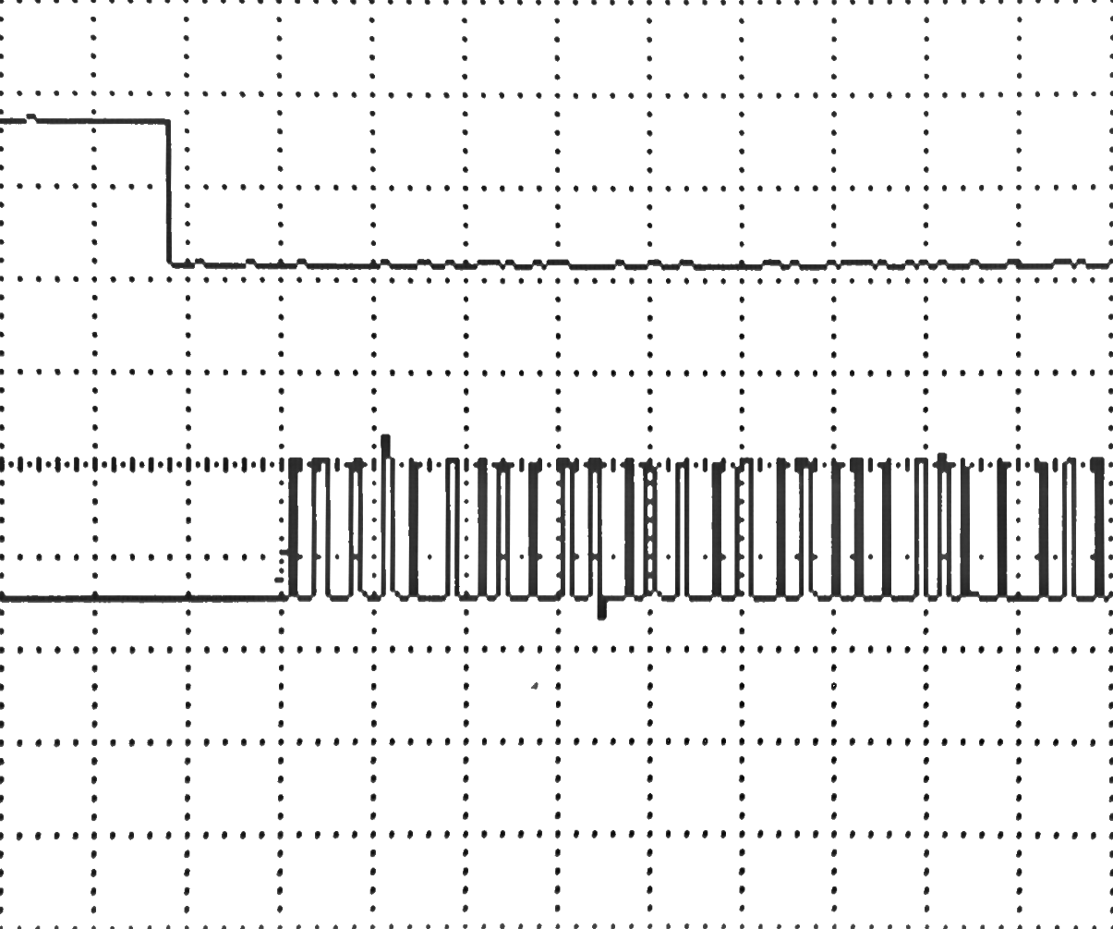
doku/oszi/15-05-04/2.png
