boomshanka/Studienarbeit/doku/oszi/15-05-11/1.jpg

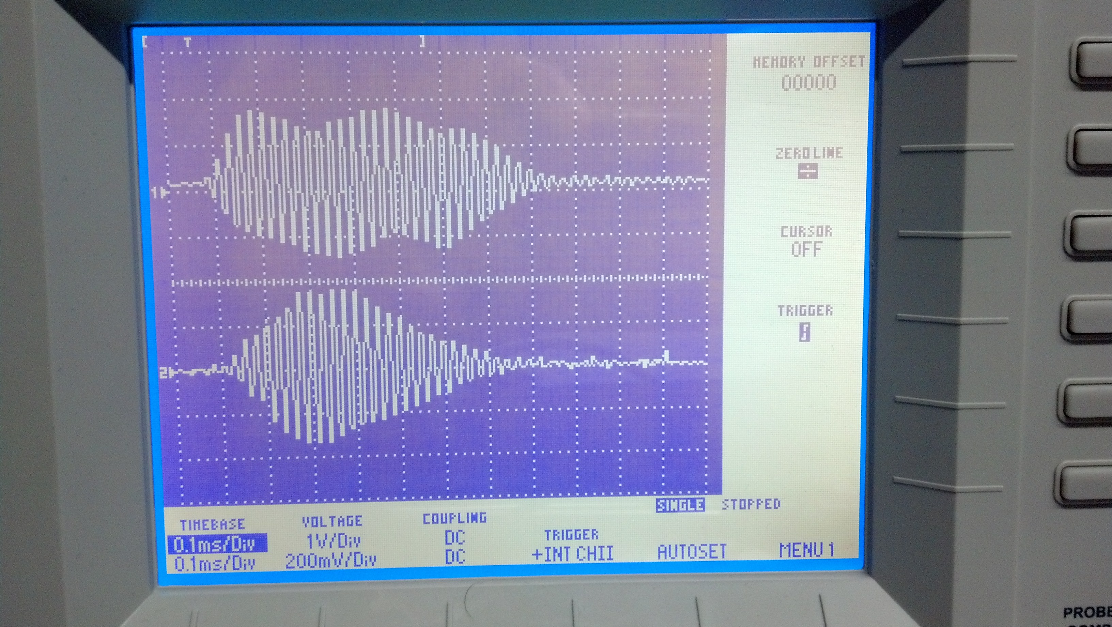
doku/oszi/15-05-11/1.jpg
