boomshanka/Studienarbeit/doku/oszi/15-05-11/1.png

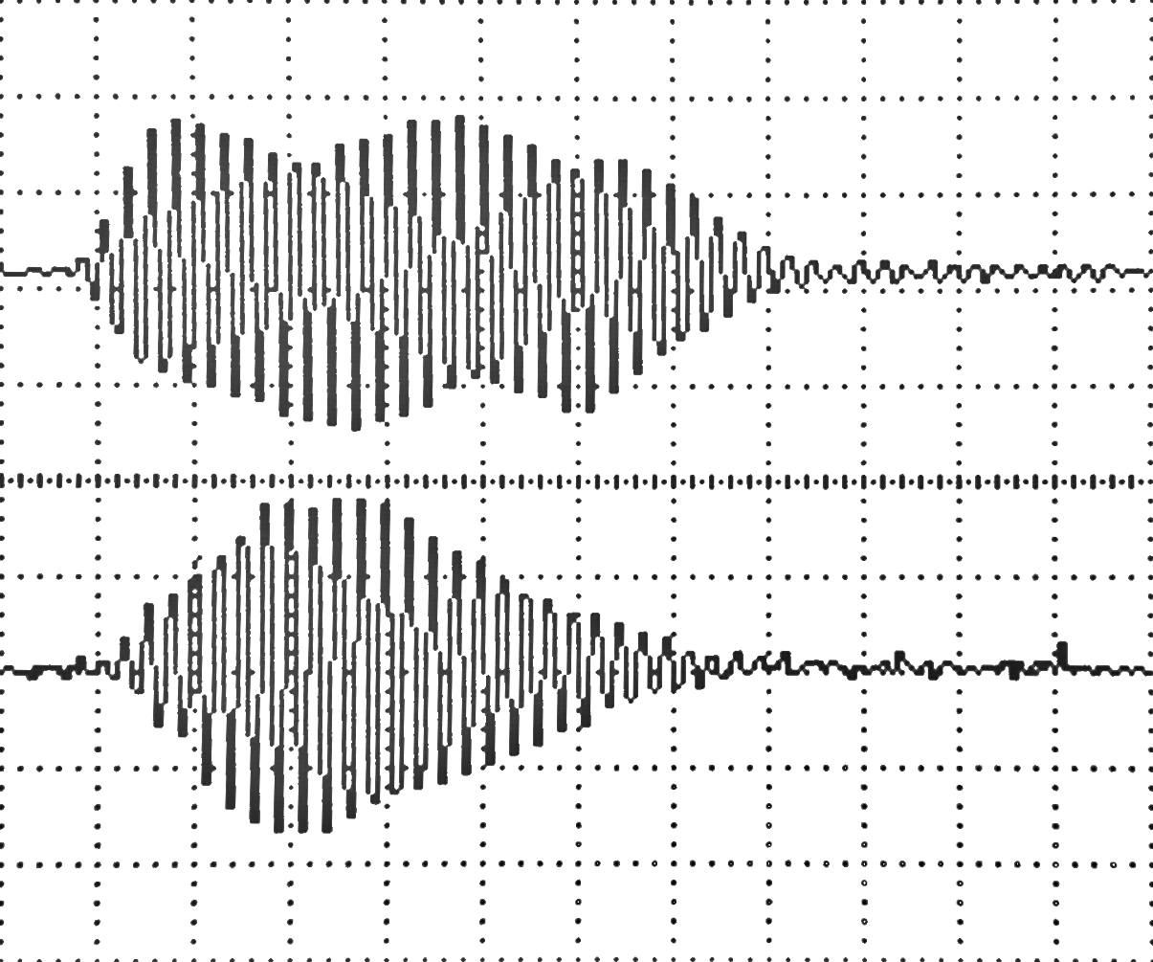
doku/oszi/15-05-11/1.png
