boomshanka/Studienarbeit/doku/oszi/15-05-11/2.jpg

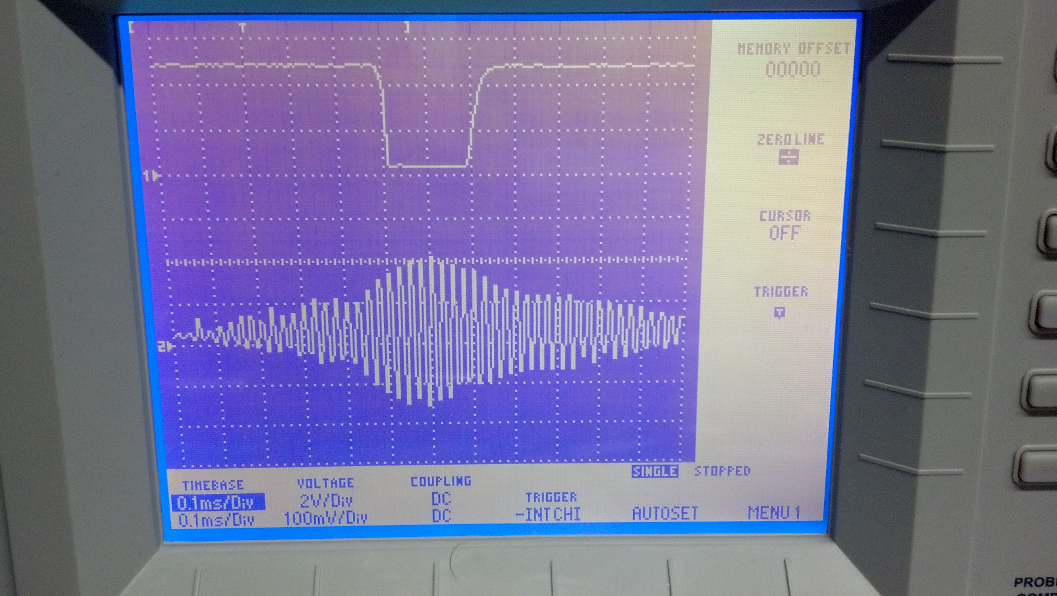
doku/oszi/15-05-11/2.jpg
