boomshanka/Studienarbeit/doku/oszi/15-05-11/2.png

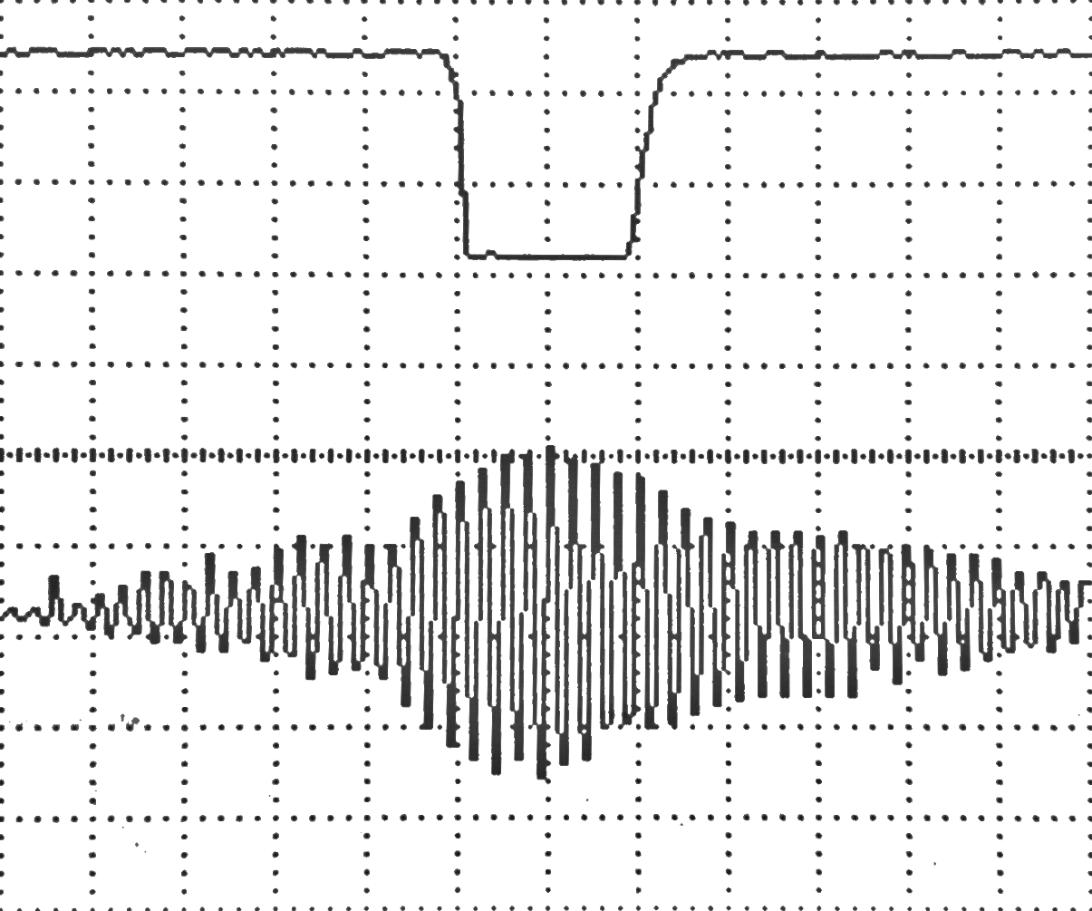
doku/oszi/15-05-11/2.png
