boomshanka/Studienarbeit/doku/oszi/15-05-15/1.jpg

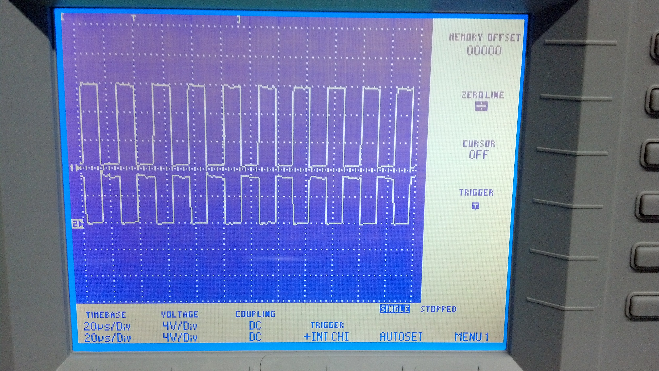
doku/oszi/15-05-15/1.jpg
