boomshanka/Studienarbeit/doku/oszi/15-05-15/1.png

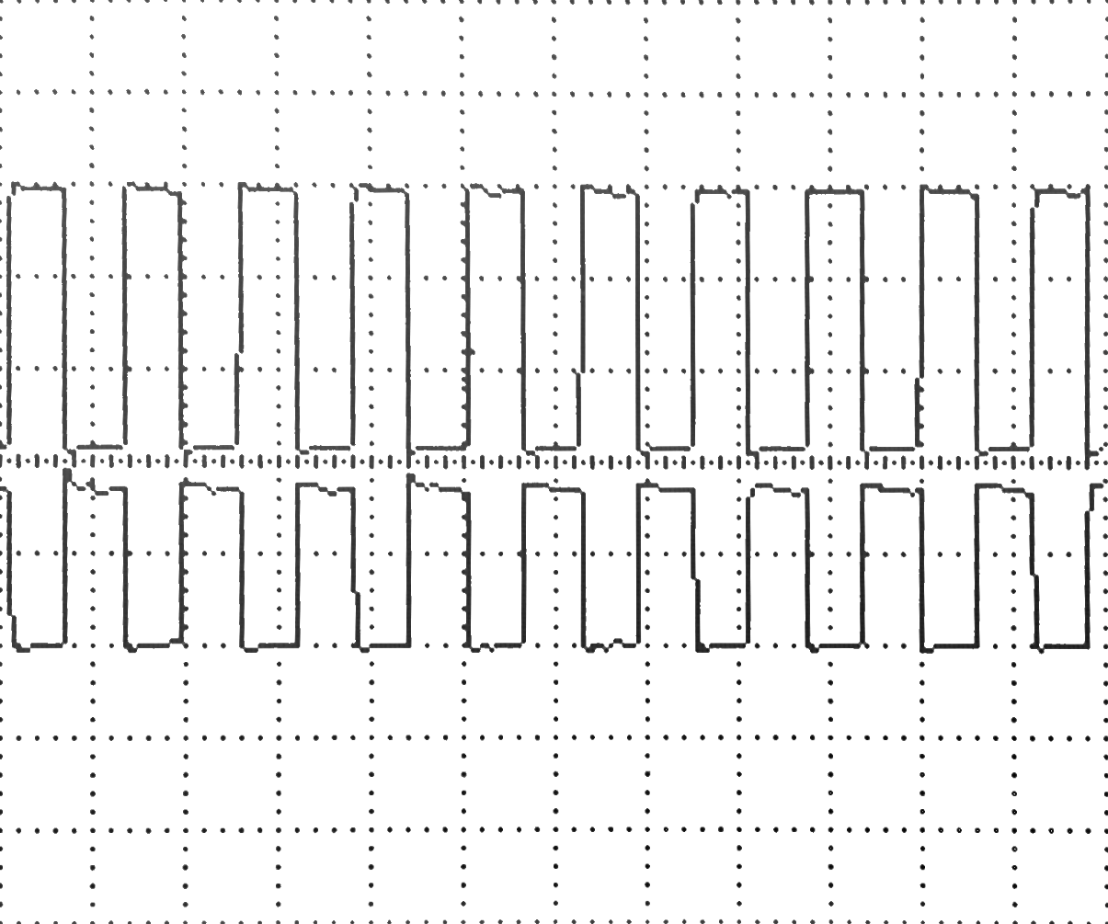
doku/oszi/15-05-15/1.png
