boomshanka/Studienarbeit/doku/oszi/15-05-15/2.jpg

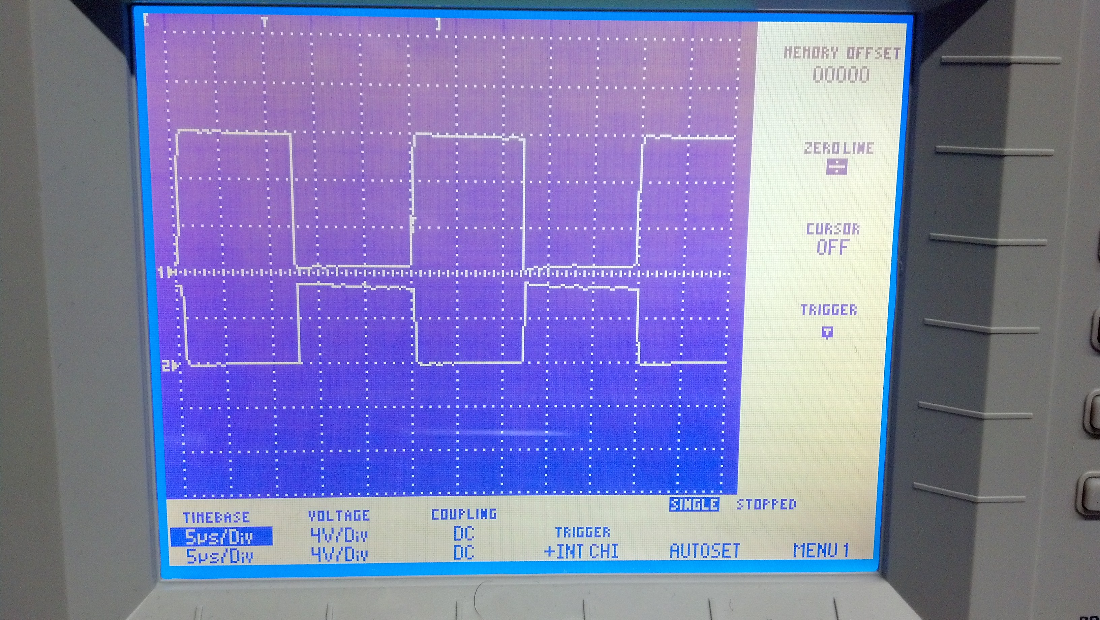
doku/oszi/15-05-15/2.jpg
