boomshanka/Studienarbeit/doku/oszi/15-05-15/2.png

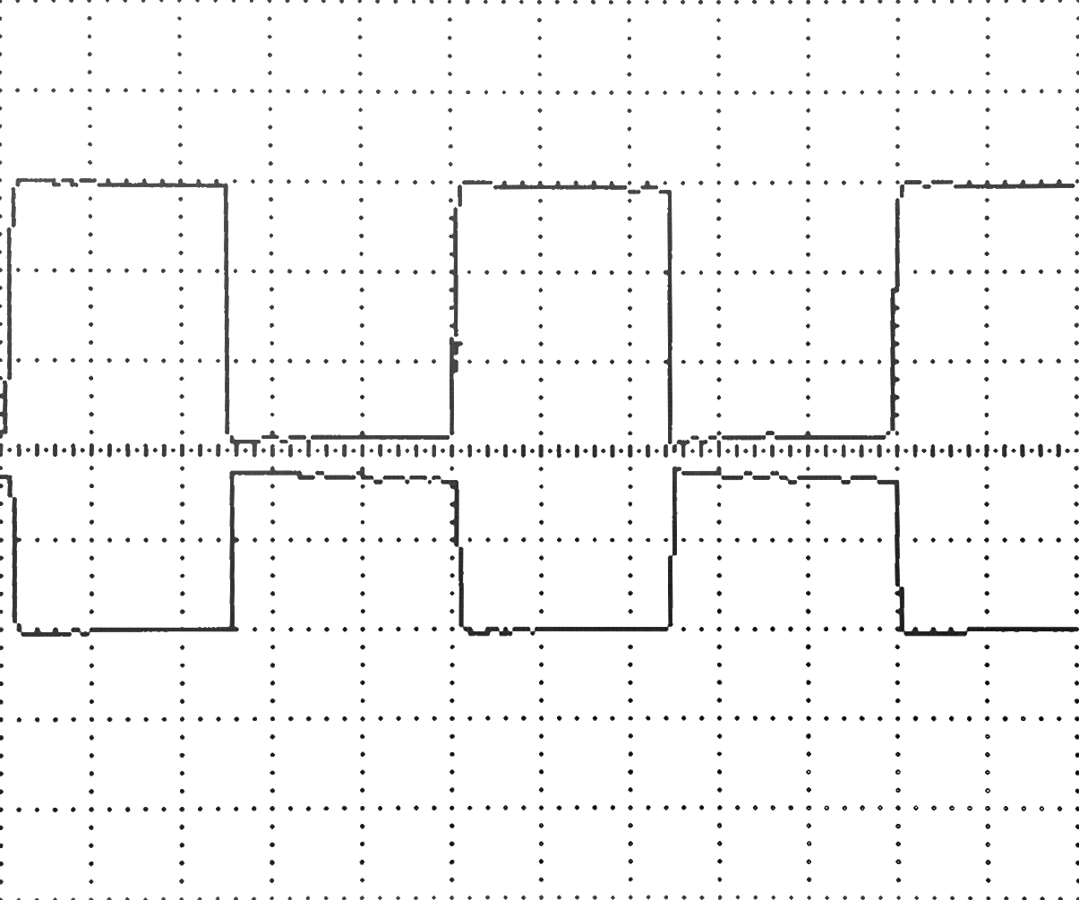
doku/oszi/15-05-15/2.png
