boomshanka/Studienarbeit/doku/oszi/15-05-15/3.png

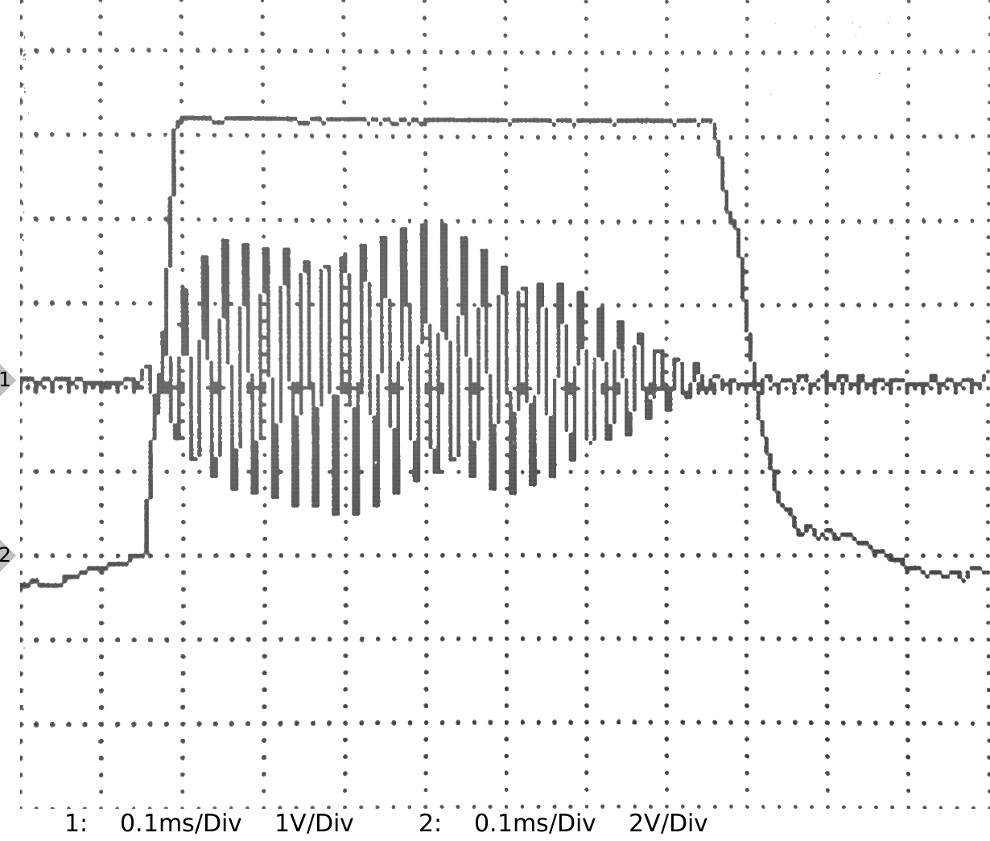
doku/oszi/15-05-15/3.png
