boomshanka/Studienarbeit/doku/oszi/15-05-30/1.png

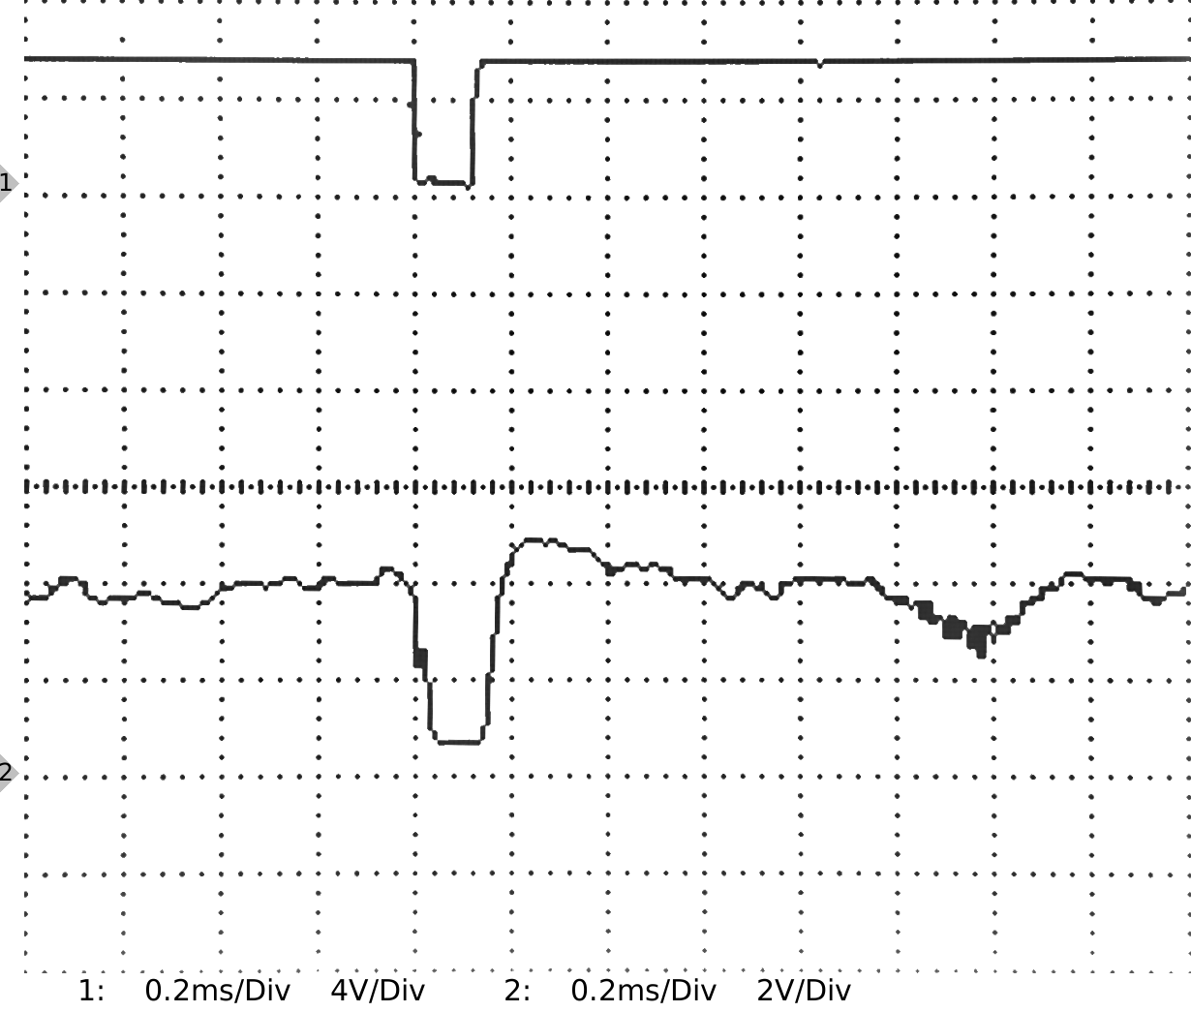
doku/oszi/15-05-30/1.png
