boomshanka/Studienarbeit/doku/sim/4mhz_tiefpasswirkung.jpg

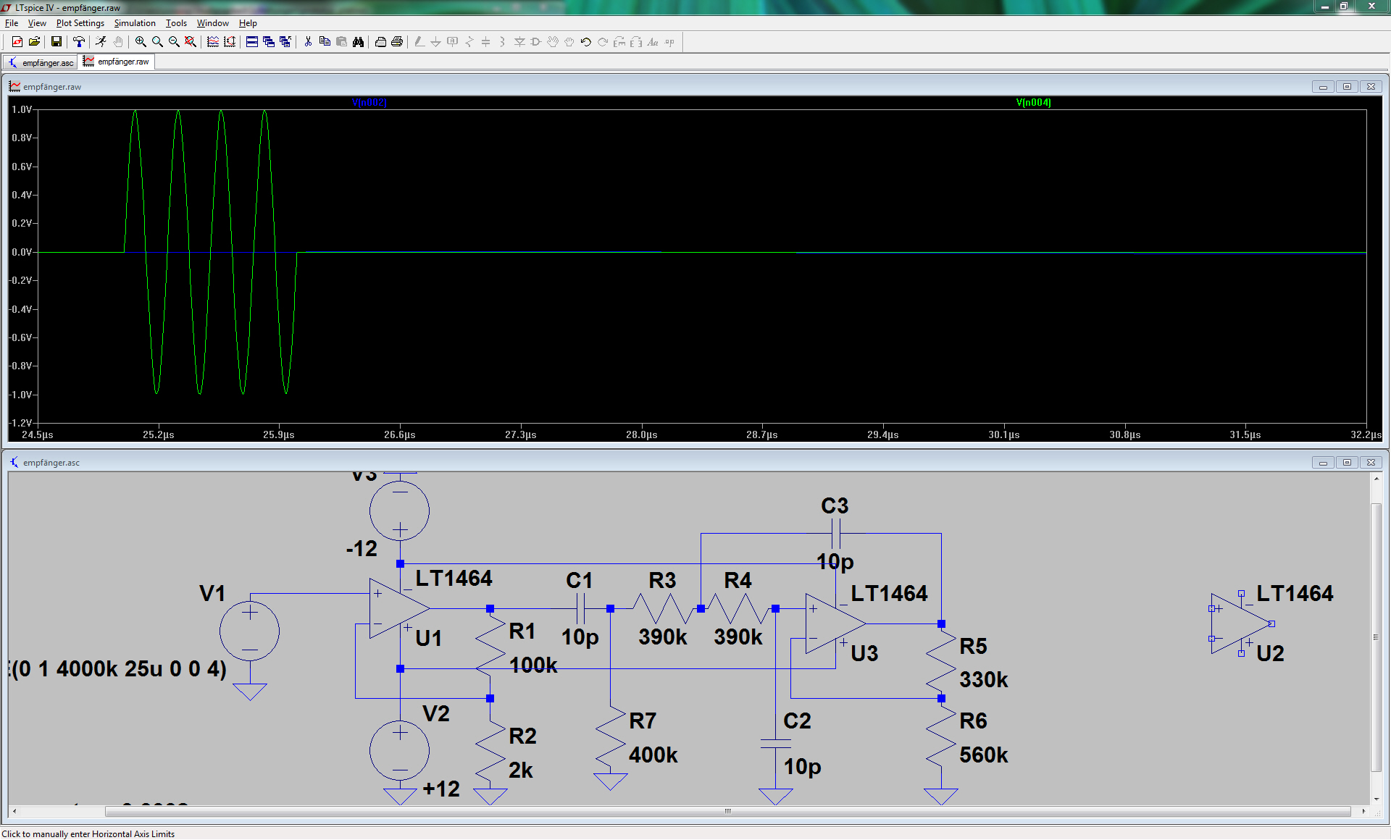
doku/sim/4mhz_tiefpasswirkung.jpg
