boomshanka/Studienarbeit/doku/sim/100hz_hochpasswirkung2.jpg

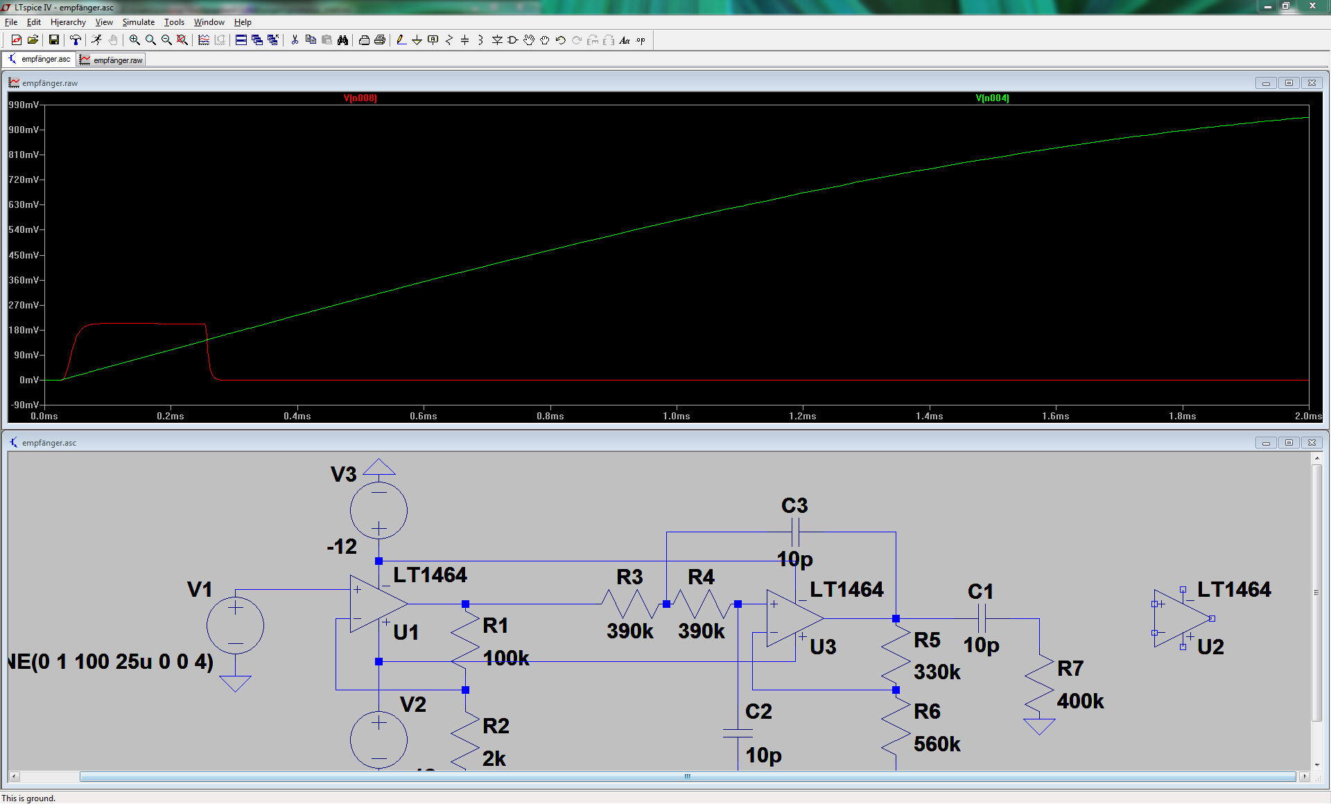
doku/sim/100hz_hochpasswirkung2.jpg
