boomshanka/Studienarbeit/doku/sim/100hz_hochpasswirkung.jpg

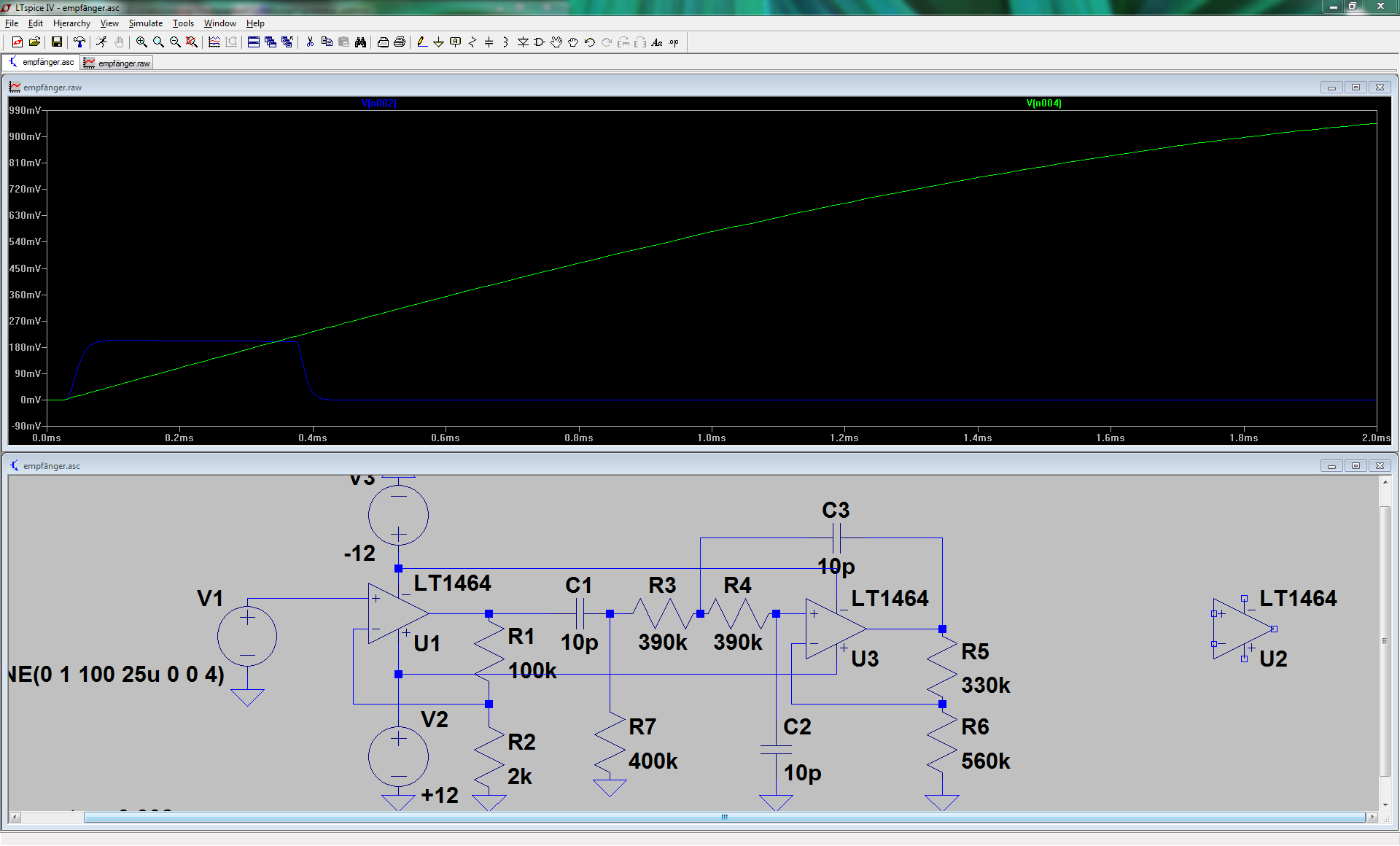
doku/sim/100hz_hochpasswirkung.jpg
