boomshanka/Studienarbeit/doku/sim/schwingen_bei_verstärkung.jpg

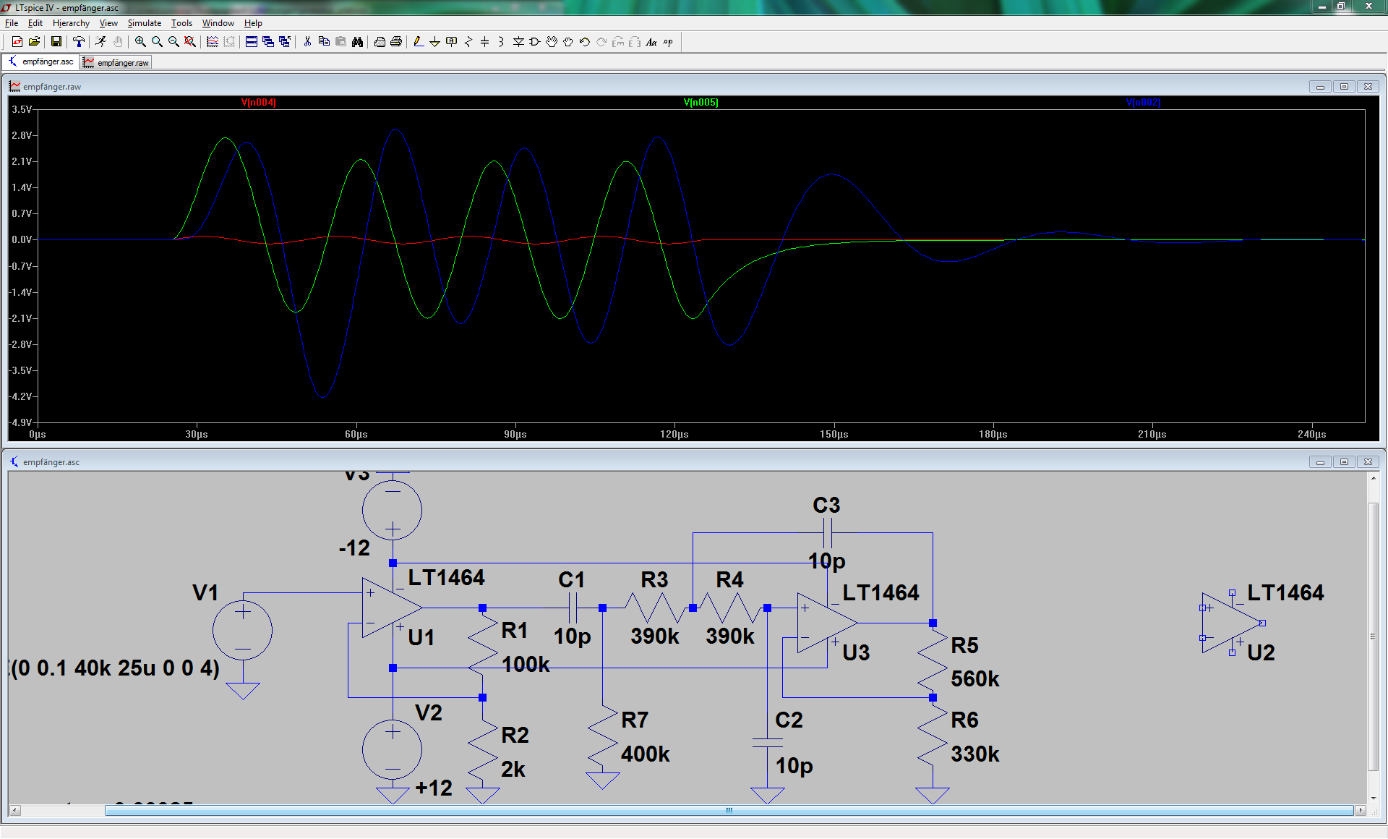
doku/sim/schwingen_bei_verstärkung.jpg
