boomshanka/Studienarbeit/doku/sim/schwingen_verstärkung_3.jpg

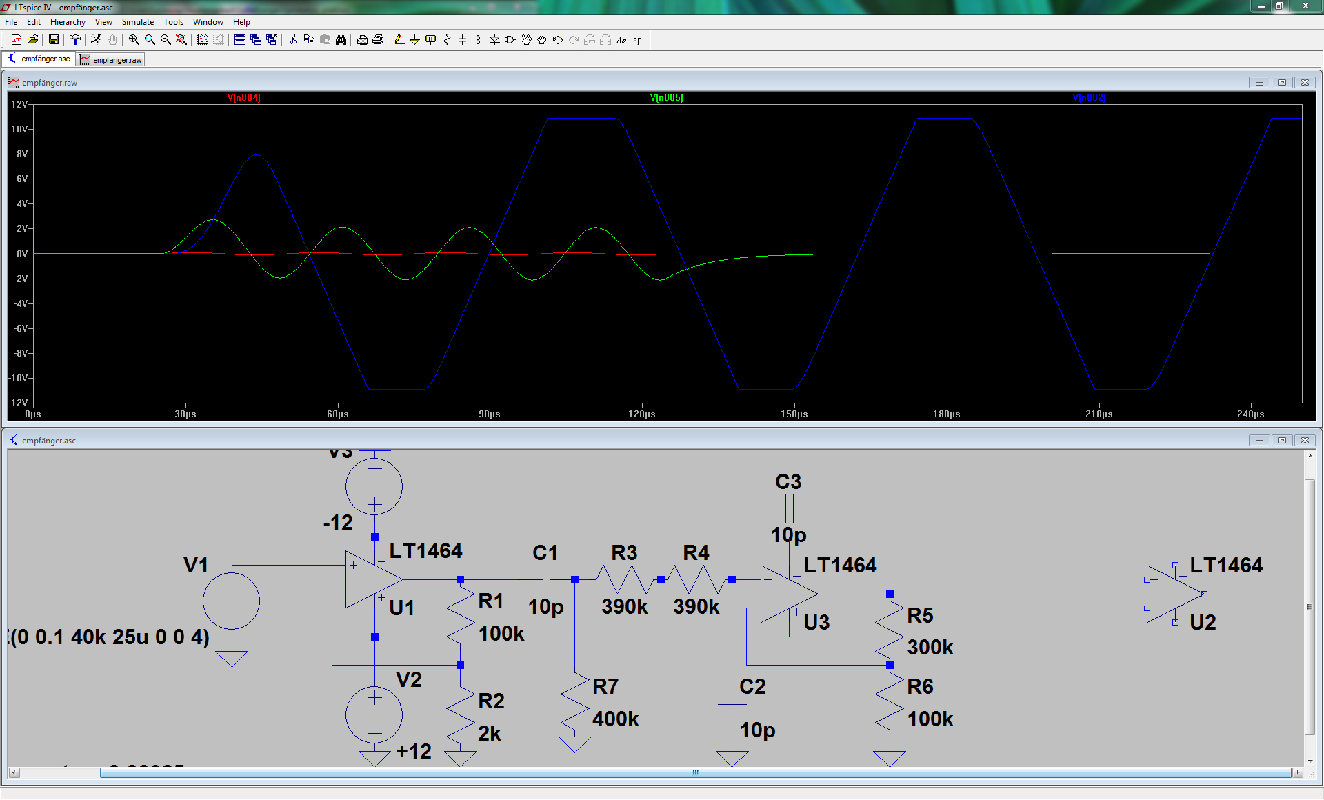
doku/sim/schwingen_verstärkung_3.jpg
