boomshanka/Studienarbeit/Schaltungen/simulationen/empfänger.asc

C1: cap; 10p
C2: cap; 100p
C3: cap; 100p
C5: cap; 10n
Q1: npn; BC337-40
R1: res; 100k
R2: res; 2k
R3: res; 33k
R4: res; 33k
R5: res; 33k
R6: res; 82k
R7: res; 400k
R9: res; 100k
R10: res; 100
R11: res; 400k
R12: res; 10k
R13: res; 5k
R14: res; 10k
R15: res; 5k
R16: res; 10k
R17: res; 10k
U1: LT1464
U2: LT1464
U3: LT1464
U4: LT1464
V1: voltage; SINE(0 0.1 400k 25u 0 0 6)
V2: voltage; +12
V3: voltage; -12
V4: voltage; 5
Named nets: 0
.tran 0.0003
