boomshanka/Studienarbeit/Schaltungen/simulationen/sender_push_pull.asc

C1: cap; 2.55n
D1: zener; 1N750
Q1: npn; BC337-25
Q2: pnp; BC327-25
Q3: pnp; BC327-25
Q4: npn; BC337-25
R1: res; 3.9k
R2: res; 100
R3: res; 10k
R4: res; 5k
R5: res; 470
R6: res; 2.2k
R7: res; 100
V1: voltage; 5; Rser=5
V2: voltage; 12; Rser=5
V3: voltage; PULSE(0 5 0 0.0000001 0.0000001 0.0000125 0.000025)
V4: voltage; 12; Rser=5
Named nets: 0
.tran 0 0.0001 0
