boomshanka/Studienarbeit/Schaltungen/simulationen/sender.asc

C2: cap; 2.55n
Q2: pnp
R1: res; 200
R4: res; 1k
V1: voltage; 5
V2: voltage; 12
V3: voltage; PULSE(0 5 0 0 0 0.0000125 0.000025)
Named nets: 0
.tran 0 0.0001 0
