boomshanka/Studienarbeit/Schaltungen/simulationen/sender_mosfet.asc

C1: cap; 2.55n
M1: pmos; BSS84
M2: nmos; BSS145
M3: nmos; BSS145
M4: pmos; BSS84
R1: res; 2k
R2: res; 4k
R6: res; 10
V2: voltage; 12; Rser=5
V3: voltage; PULSE(0 12 0 0.0000001 0.0000001 0.0000125 0.000025)
V4: voltage; 12; Rser=5
Named nets: 0
.tran 0 0.0001 0
