boomshanka/Studienarbeit/Schaltungen/verteilerplatine/verteilerplatine.kicad_pcb

## KiCad design Schaltungen/verteilerplatine/verteilerplatine.kicad_pcb (2015-07-06)

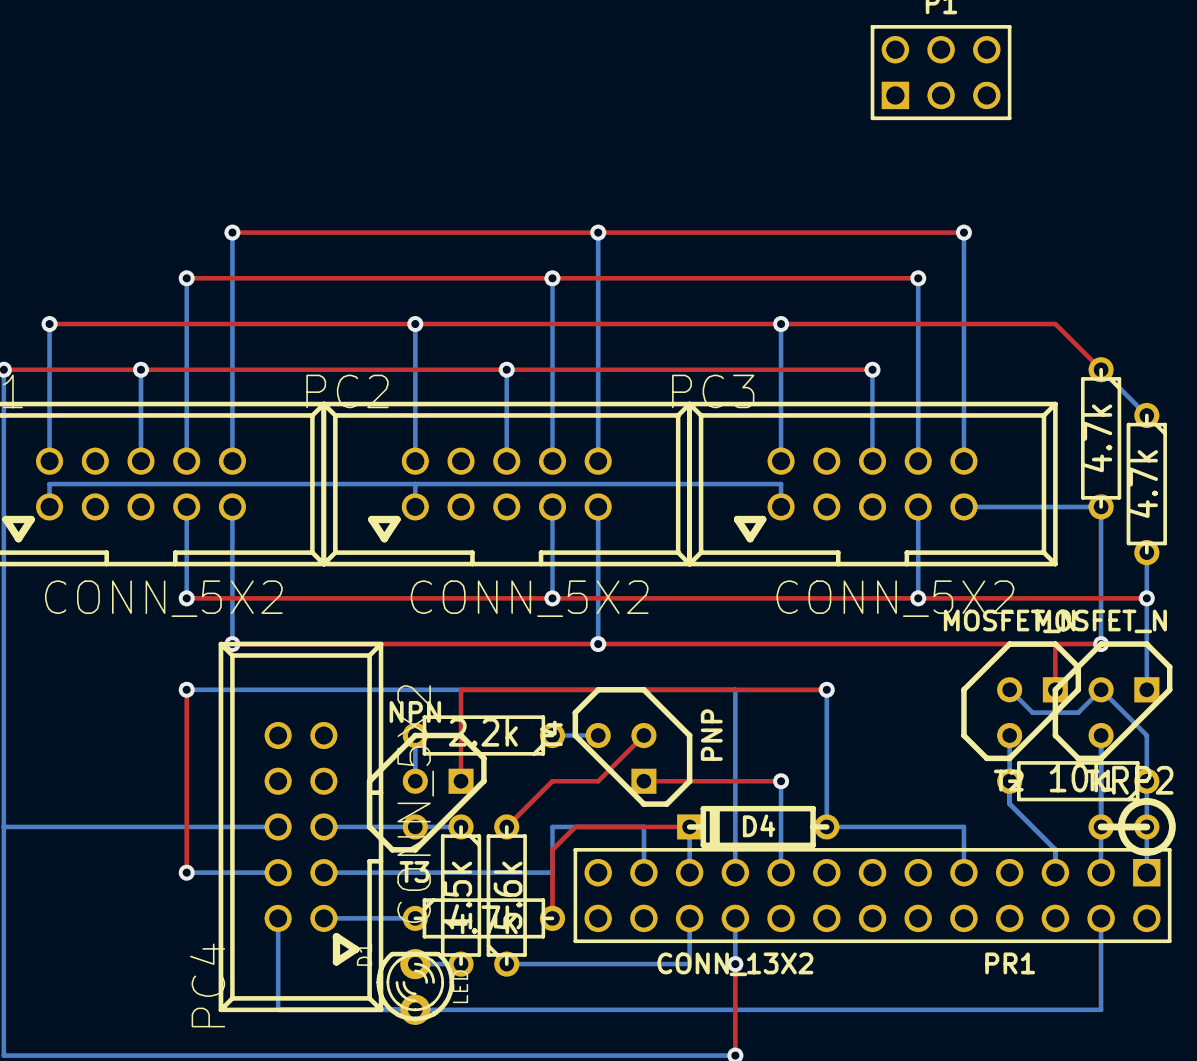
[picture p82: board verteilerplatine.kicad_pcb from above]

Board: 2 copper layers, 20 parts (0 on the bottom side), 20 nets.

Parts:
D1: LED; LED-3MM
D4: 3.3V; D3
P1: DIN_5; pin_array_3x2
PC1, PC2, PC3, PC4: CONN_5X2; VASCH5x2
PR1: CONN_13X2; pin_array_13x2
R1: 2.2k; R3
R2: 5.6k; R3
R3: 4.7k; R3
RD1: 1.5k; R3
RP1: 10k; R3
RP2: 10k; R1
RP3, RP4: 4.7k; R3
T1, T2: MOSFET_N; TO92DGS
T3: NPN; TO92
T4: PNP; TO92

Connections:
+3.3V: PR1.1, PR1.17, RP1.1, RP2.1, T1.G, T2.G, T4.1
+5V: D1.1, P1.1, PC1.2, PC2.2, PC3.2, PC4.2, PR1.2, PR1.4, RP3.1, RP4.1
+12V: P1.2, PC1.8, PC2.8, PC3.8
-12V: P1.4, PC1.10, PC2.10, PC3.10
/Mikrocontroller/MISO: PC4.1, R3.1
/Mikrocontroller/MOSI: PC4.4, PR1.19
/Mikrocontroller/Reset: PC4.5, RD1.1, T3.3
/Mikrocontroller/SCK: PC4.3, PR1.23
/Mikrocontroller/SCL: PC1.9, PC2.9, PC3.9, RP3.2, T2.D
/Mikrocontroller/SDA: PC1.7, PC2.7, PC3.7, RP4.2, T1.D
/RaspberryPI/MISO: D4.2, PR1.21, R3.2
/RaspberryPI/Reset: PR1.22, R2.1
/RaspberryPI/SCL: PR1.5, RP1.2, T2.S
/RaspberryPI/SDA: PR1.3, RP2.2, T1.S
GND: D4.1, P1.3, PC1.6, PC2.6, PC3.6, PC4.6, PR1.6, PR1.9, PR1.14, PR1.20, PR1.25, T3.1
unnamed: R2.2, T4.2
unnamed: R1.1, T4.3
unnamed: R1.2, T3.2
unnamed: PC1.1, PC2.1, PC3.1
unnamed: D1.2, RD1.2
