boomshanka/Studienarbeit/Schaltungen/endplatine/endplatine.kicad_pcb

## KiCad design Schaltungen/endplatine/endplatine.kicad_pcb (2015-05-15)

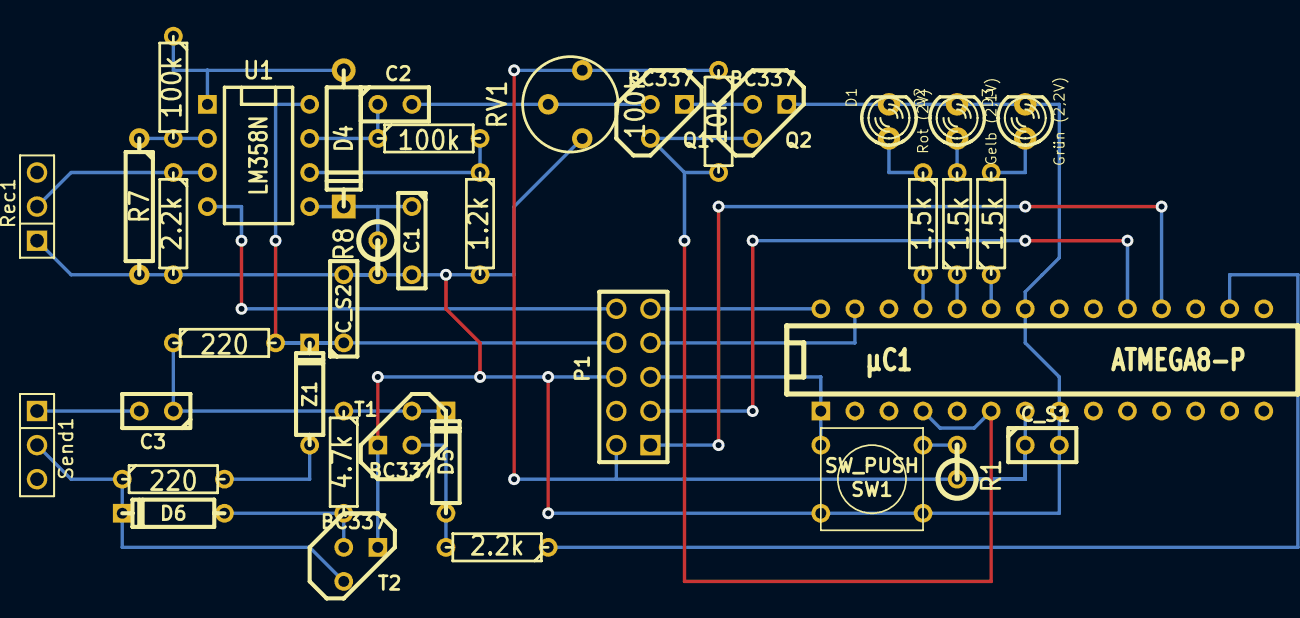
[picture p83: board endplatine.kicad_pcb from above]

Board: 2 copper layers, 38 parts (0 on the bottom side), 32 nets.

Parts:
C1: 100p; C2
C2: 10n; C1
C3: 100n; C1
C_S1: 100n; C1
C_S2: 100n; C2
D1: Rot (2V); LED-3MM
D2: Gelb (2,1V); LED-3MM
D3: Grün (2,2V); LED-3MM
D4: DIODE; D4
D5, D6: DIODE; D3
P1: CONN_5X2; PIN_ARRAY_5x2
Q1, Q2: BC337; TO92-EBC
R1: 10k; R1
R2, R3, R4: 1,5k; R3
R5: 2.2k; R3
R6, R9: 100k; R3
R7: 1.2k; R4
R8: 560k; R1
R10: 1.2k; R3
R11: 10k; R3
R12, R13: 220; R3
RB1: 2.2k; R3
RB2: 4.7k; R3
RV1: 100k; RV2
Rec1: 2.55nF; PIN_ARRAY_3X1
SW1: SW_PUSH; SW_PUSH_SMALL
Send1: 2,55n; PIN_ARRAY_3X1
T1, T2: BC337; TO92-EBC
U1: LM358N; DIP-8__300
Z1: 3.9V; D3
µC1: ATMEGA8-P; DIP-28__300

Connections:
+5V: C_S1.1, P1.2, R1.1, R11.1, RV1.3, µC1.7
+12V: C_S2.1, P1.8, R12.2, U1.8, Z1.2
-12V: P1.10, U1.4
/Mikrocontroller/Empfänger/Signal: Q1.C, Q2.C, R11.2, µC1.4, µC1.6
/Mikrocontroller/Sender/40kHz PWM: RB1.1, µC1.16
GND: C1.2, C_S1.2, C_S2.2, D1.2, D2.2, D3.2, P1.6, Q2.E, R5.2, R7.2, R8.2, R10.2, RV1.1, Rec1.1, SW1.1, T1.E, T2.E, µC1.8, µC1.22
MISO: P1.1, µC1.18
MOSI: P1.4, µC1.17
unnamed: R3.1, µC1.24
unnamed: R4.2, µC1.25
unnamed: D3.1, R2.2
unnamed: D2.1, R3.2
unnamed: D1.1, R4.1
unnamed: R2.1, µC1.23
unnamed: C3.2, Send1.1
unnamed: R13.2, Z1.1
unnamed: C3.1, D5.2, R12.1, RB2.1, T1.C
unnamed: D5.1, RB1.2, T1.B
unnamed: D6.2, R13.1, Send1.2, T2.C
unnamed: D6.1, RB2.2, T2.B
unnamed: R6.2, R7.1, U1.2
unnamed: D4.1, R6.1, U1.1
unnamed: C2.1, R9.1, U1.7
unnamed: Q1.E, Q2.B
unnamed: R9.2, R10.1, U1.6
unnamed: R5.1, Rec1.2, U1.3
unnamed: C2.2, Q1.B, RV1.2
unnamed: C1.1, D4.2, R8.1, U1.5
Reset: P1.5, R1.2, SW1.2, µC1.1
SCK: P1.3, µC1.19
SCL: P1.9, µC1.28
SDA: P1.7, µC1.27
