boomshanka/Studienarbeit/Schaltungen/prototyp_platine_v2/prototyp_platine.kicad_pcb

## KiCad design Schaltungen/prototyp_platine_v2/prototyp_platine.kicad_pcb (2015-04-16)

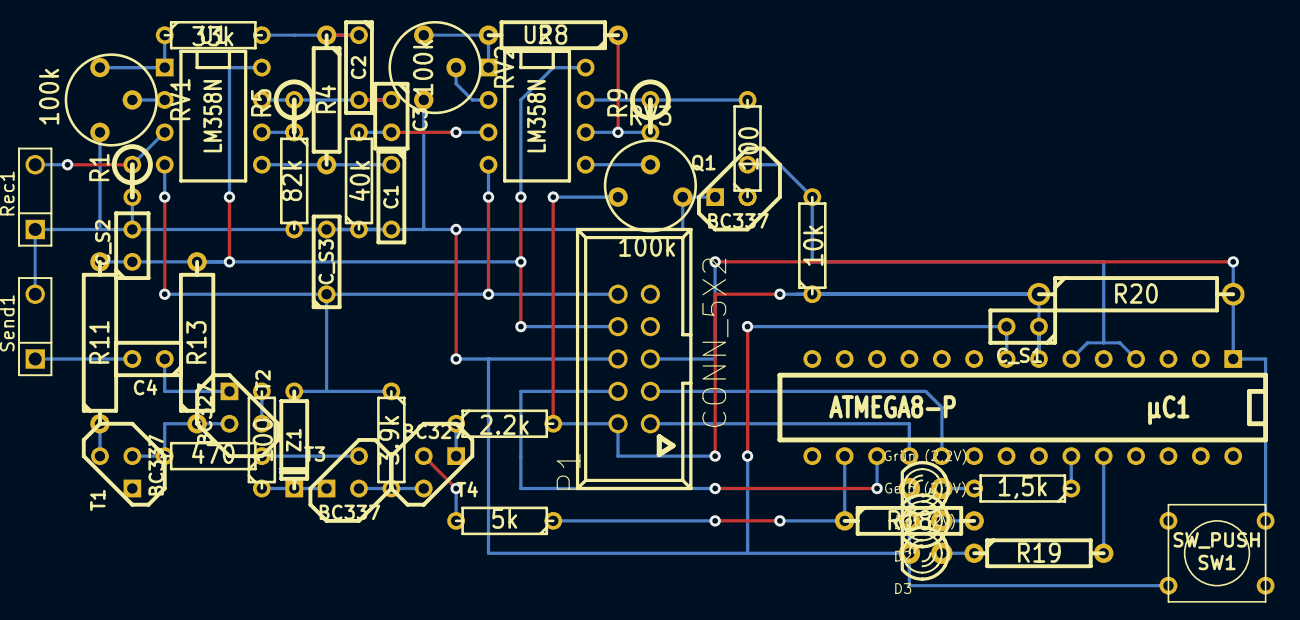
[picture p84: board Schaltungen/prototyp_platine_v2/prototyp_platine.kicad_pcb from above]

Board: 2 copper layers, 47 parts (0 on the bottom side), 41 nets.

Parts:
C1, C2: 100p; C2
C3: 100p; C1
C4: 100n; C1
C_S1, C_S2: 100n; C1
C_S3: 100n; C2
D1: Grün (2,2V); LED-3MM
D2: Gelb (2,1V); LED-3MM
D3: Rot (2V); LED-3MM
P1: CONN_5X2; VASCH5x2
Q1: BC337; TO92-EBC
R1: 1.8k; R1
R3: 33k; R3
R4: 33k; R4
R5: 33k; R1
R6: 82k; R3
R7: 40k; R3
R8: 10k; R4
R9: 10k; R1
R10: 10k; R3
R11: 100; R5
R12: 100; R3
R13: 10k; R5
R14: 470; R3
R15: 2.2k; R3
R16: 3.9k; R3
R17: 1,5k; R3
R18, R19: 1,5k; R4
R20: 10k; R6
RB1: 100; R3
RB2: 5k; R3
RV1, RV2, RV3: 100k; RV2
Rec1: 2.55nF; PIN_ARRAY_3X1
SW1: SW_PUSH; SW_PUSH_SMALL
Send1: 2,55n; PIN_ARRAY_3X1
T1, T3: BC337; TO92-EBC
T2, T4: BC327; TO92-EBC
U1, U2: LM358N; DIP-8__300
Z1: 3.9V; D3
µC1: ATMEGA8-P; DIP-28__300

Connections:
+5V: C_S1.1, P1.2, R10.1, R15.2, R20.1, RV3.1, µC1.7
+12V: C_S2.1, P1.8, R11.2, R13.2, U1.8, U2.8
-12V: C_S3.1, P1.10, R16.1, U1.4, U2.4, Z1.1
/Mikrocontroller/Empfänger/Signal: Q1.C, R10.2, µC1.4, µC1.6
/Mikrocontroller/Sender/40kHz PWM: R18.1, RB2.1, µC1.16
GND: C1.2, C_S1.2, C_S2.2, C_S3.2, D1.2, D2.2, D3.2, P1.6, Q1.E, R1.2, R6.2, R7.1, RV1.3, RV2.3, RV3.3, Rec1.1, SW1.1, Send1.2, µC1.8
MISO: P1.1, µC1.18
MOSI: P1.4, µC1.17
unnamed: D1.1, R17.2
unnamed: D3.1, R19.1
unnamed: R19.2, µC1.24
unnamed: R17.1, µC1.23
unnamed: D2.1, R18.2
unnamed: C4.1, T1.E, T2.E
unnamed: R14.1, T3.C
unnamed: C4.2, Send1.1
unnamed: R11.1, T1.C
unnamed: R12.1, T3.E, Z1.2
unnamed: R12.2, T2.C
unnamed: R13.1, R14.2, T1.B, T2.B
unnamed: RB2.2, T4.B
unnamed: R15.1, T4.E
unnamed: R16.2, T3.B, T4.C
unnamed: C3.2, R7.2, U2.3
unnamed: R8.2, RV2.1, U2.1
unnamed: RV2.2, U2.2
unnamed: C2.2, C3.1, R5.1, U1.7
unnamed: R9.1, RB1.2, U2.7
unnamed: RV3.2, U2.5
unnamed: R8.1, R9.2, U2.6
unnamed: R5.2, R6.1, U1.6
unnamed: C2.1, R3.2, R4.1
unnamed: C1.1, R4.2, U1.5
unnamed: R1.1, Rec1.2, U1.3
unnamed: Q1.B, RB1.1
unnamed: R3.1, RV1.1, U1.1
unnamed: RV1.2, U1.2
Reset: P1.5, R20.2, SW1.2, µC1.1
SCK: P1.3, µC1.19
SCL: P1.9, µC1.28
SDA: P1.7, µC1.27
