boomshanka/Studienarbeit/Schaltungen/prototyp_platine/prototyp_platine.kicad_pcb

## KiCad design Schaltungen/prototyp_platine/prototyp_platine.kicad_pcb (2015-01-15, an earlier design)

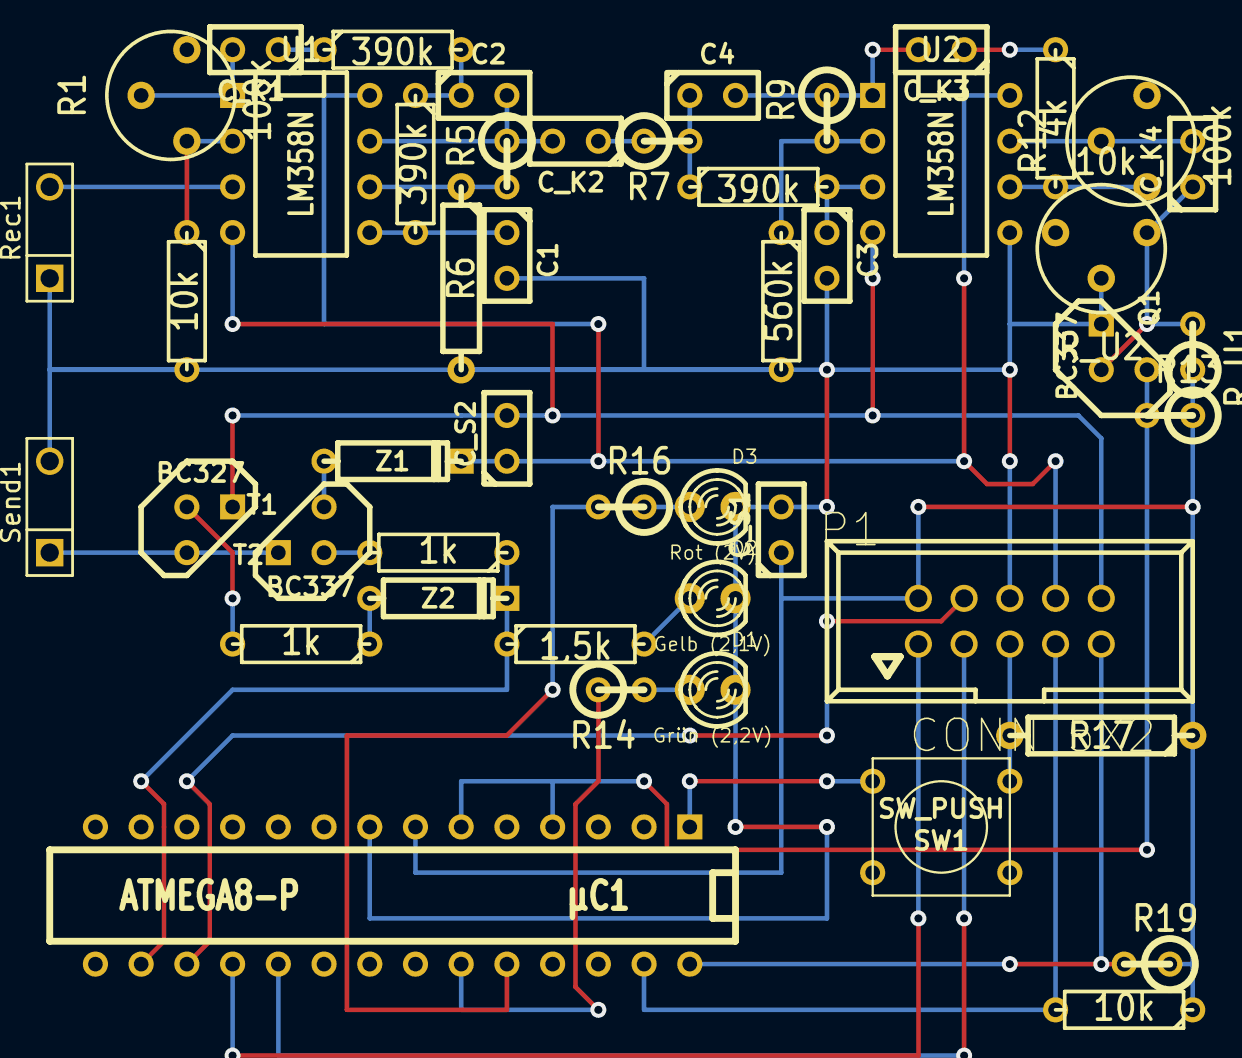
[picture p85: board Schaltungen/prototyp_platine/prototyp_platine.kicad_pcb from above]

Board: 2 copper layers, 48 parts (0 on the bottom side), 39 nets.

Parts:
C1, C2, C3, C4: 10p; C1
C_K1, C_K2: 10p; C1
C_K3: 1n; C1
C_K4: >500p, 100n; C1
C_S1, C_S2: 100n; C1
D1: Grün (2,2V); LED-3MM
D2: Gelb (2,1V); LED-3MM
D3: Rot (2V); LED-3MM
P1: CONN_5X2; VASCH5x2
Q1: BC337; TO92-EBC
R1, R12: 100k; RV2
R2, R18: 10k; R3
R3, R4, R8: 390k; R3
R5, R9: 330k; R1
R6: 560k; R4
R7: 390k; R1
R10: 560k; R3
R11: 4k; R3
R13, R19: 10k; R1
R14, R16: 1,5k; R1
R15: 1,5k; R3
R17: 10k; R4
R_B1, R_B2: 1k; R3
R_U1: 47k; R1
R_U2: 10k; RV2
Rec1: Empfänger; PIN_ARRAY_3X1
SW1: SW_PUSH; SW_PUSH_SMALL
Send1: 2,55n; PIN_ARRAY_3X1
T1: BC337; TO92-EBC
T2: BC327; TO92-EBC
U1, U2: LM358N; DIP-8__300
Z1: 4V; D3
Z2: 12V; D3
µC1: ATMEGA8-P; DIP-28__300

Connections:
+5V: C_S1.1, P1.2, R13.1, R17.1, R18.1, R19.1, R_U1.1, µC1.7
+12V: C_S2.1, P1.8, U1.8, U2.8, Z1.2
-12V: C_S2.2, P1.10, T2.E, U1.4, U2.4
/Empfänger/Signal: Q1.C, R13.2, µC1.4, µC1.6
/Mikrocontroller/40kHz PWM: R15.1, R_B1.1, Z2.2, µC1.16
GND: C1.2, C3.2, C_S1.2, D1.2, D2.2, D3.2, P1.6, Q1.E, R2.2, R6.2, R10.2, R_U2.2, Rec1.1, SW1.1, Send1.2, U2.5, µC1.8
MISO: P1.1, µC1.18
MOSI: P1.4, µC1.17
unnamed: D3.1, R16.1
unnamed: D1.1, R14.2
unnamed: R16.2, µC1.24
unnamed: R14.1, µC1.23
unnamed: D2.1, R15.2
unnamed: Send1.1, T1.E, T2.C
unnamed: R_B1.2, T1.B
unnamed: T1.C, Z1.1
unnamed: R_B2.2, T2.B
unnamed: R_B2.1, Z2.1
unnamed: C_K1.2, R1.2, U1.1
unnamed: R1.1, R2.1, U1.2
unnamed: Rec1.2, U1.3
unnamed: C_K3.1, R11.1
unnamed: R11.2, R12.1, U2.6
unnamed: C_K1.1, R3.1
unnamed: C4.2, C_K3.2, R9.1, U2.1
unnamed: C_K2.1, R7.1
unnamed: C2.2, C_K2.2, R5.1, U1.7
unnamed: C_K4.2, R12.2, U2.7
unnamed: C_K4.1, Q1.B, R_U1.2, R_U2.1
unnamed: R9.2, R10.1, U2.2
unnamed: R5.2, R6.1, U1.6
unnamed: C2.1, R3.2, R4.1
unnamed: C1.1, R4.2, U1.5
unnamed: C3.1, R8.2, U2.3
unnamed: C4.1, R7.2, R8.1
Reset: P1.5, R17.2, SW1.2, µC1.1
SCK: P1.3, µC1.19
SCL: P1.9, R19.2, µC1.28
SDA: P1.7, R18.2, µC1.27
