boomshanka/Studienarbeit/schaltungen/sender.sch

## EAGLE design schaltungen/sender.sch (2014-12-01)

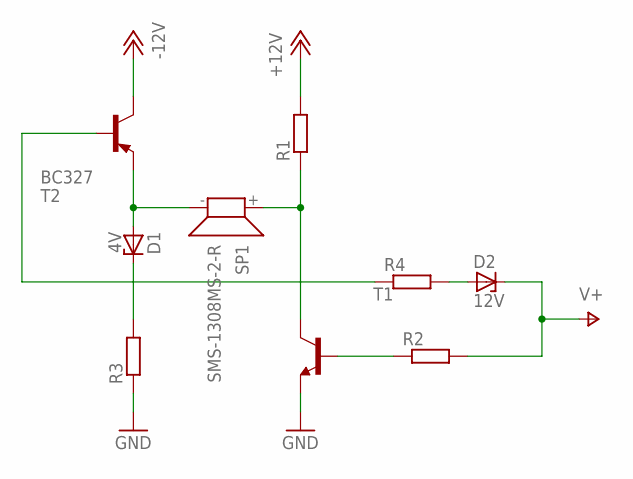
[picture p86: schematic sender.sch]

Parts:
D1: 4V; C1702-15
D2: 12V; C1702-15
R1, R2, R3, R4: R-EU_0204_7; 0204/7
SP1: SMS-1308MS-2-R
T1: -NPN-TO92L; TO92L
T2: BC327; TO92

Connections:
+12V: R1.2
-12V: T2.3 (C)
GND: R3.1, T1.1 (E)
unnamed: R1.1, SP1.+ (1), T1.3 (C)
unnamed: R2.1, T1.2 (B)
unnamed: D1.C, R3.2
unnamed: D1.A, SP1.- (2), T2.1 (E)
unnamed: D2.A, R4.2
unnamed: R4.1, T2.2 (B)
V+: D2.C, R2.2
