boomshanka/Studienarbeit/firmware/time_of_flight.h

#ifndef _TIME_OF_FLIGHT_H__
#define _TIME_OF_FLIGHT_H__

#define TOF_RUNNING 0
#define TOF_WAITING	1
#define TOF_STOPPED	2
#define TOF_DIRECT	3
#define TOF_SUCCESS	4
#define TOF_TIMEOUT	5

#include <stdint.h>


extern volatile uint8_t tof_flag;


void		tof_init(void);

void		tof_startmes(void);
void		tof_stopmes(void);
uint16_t	tof_getresult(void);

void		tof_waitfortrigger(void);
void		tof_sendtrigger(void);


#endif
