boomshanka/Studienarbeit/(commit log)

2014-12-01 Entwurf von Schaltplan für Senderverstärker hinzugefügt.
    [sender.sch]
2014-12-02 Datenblatt und Pinbelegung von ATmega8 und Pinbelegung von GPIO-Interface hinzugefügt.
2014-12-03 Erster Code für Firmware hinzugefügt, 40kHz-Signal wird per FastPWM erzeugt.
2014-12-25 Sourcecode für Two-Wire-Interface (I²C) hinzugefügt.
2014-12-26 Grobe Strukturierung der Dokumentation.
2014-12-26 Dokument >Operationsverstärker in der Praxis< zur Entwicklung von Filterschaltungen hinzugefügt.
2015-01-02 Sender-Schaltungen (12V und 20V) hinzugefügt. Programm zum öffnen: EAGLE (http://www.cadsoft.de/eagle-pcb-design-software/)
    [sender_einfach_12v.sch, sender_einfach_20v.sch]
2015-01-02 Aktive Filter (HP & TP) für die Empfängerschaltung hinzugefügt.
    [filter.sch]
2015-01-03 TWI-Modul aufgeteilt in Master und Slave. Master-Modul wird wahrscheinlich nicht benötigt, da bisher R-PI einziger Master auf dem Bus ist.
2015-01-03 Bilder von Oszi (incl Beschreibung) des letzten Labortermins hinzugefügt.
2015-01-09 Vollständiger Schaltplan für Prototyp-Platine hinzugefügt. Softwareumstieg von EAGLE->KiCAD ( http://www.kicad-pcb.org/ ). .gitignore erweitert.
    [Empfänger.sch, Mikrocontroller.sch, Sender.sch, filter.sch, prototyp_platine.kicad_pcb, prototyp_platine.sch, sender_einfach_12v.sch, sender_einfach_20v.sch]
2015-01-09 Berechnung des aktiven Tiefpassfilters, verbaut auf Prototyp-Platine. Öffnen mit Programm: AktivFilter 3.2 ( http://www.aktivfilter.de/ ).
2015-01-09 Kleinere Änderungen am Schaltplan, Footprint-Liste hinzugefügt.
    [Empfänger.sch, Mikrocontroller.sch, Sender.sch, prototyp_platine.sch]
2015-01-11 Platinenentwurf fertig.
    [Empfänger.sch, Mikrocontroller.sch, Sender.sch, prototyp_platine.kicad_pcb, prototyp_platine.sch]
2015-01-23 Empfänger-Schaltung nach ursprünglicher Idee vollständig (allerdings nur eine Filterstufe) und funktioniert. Einige Änderungen sind aber noch sinnvoll.
2015-01-23 Invertierenden Verstärker in Nicht-invertierenden Verstärker mit (neg.) Offset umgewandelt -> Entkopplung des Transistors mit Kondensator ist nicht mehr nötig, Signal wird dadurch präziser.
2015-01-26 Schaltung "sender.asc": Ganz simple Sendeschaltung mit einem Transistor und 17V U_ss. Laden über R, dauerhafter Stromfluss bei Signal. Schaltung "sender_push_pull.asc": Aufwendige Schaltung mit Push-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
2015-01-27 Sender Push-Pull komplett überarbeitet. Funktioniert jetzt mit zwei NPN in der Endstufe.
2015-01-29 Empfängerschaltung aktualisiert: Invertierender Verstärker an erster Stelle wg nötigen Eingangswiderstand für Hochpass zwischen Verstärker und Empfänger.
2015-02-04 Doku: -Kapitel Schaltungen->Entwicklung. Soll allgemein die Entwicklung von Schaltungen und Software, sowie Architektur der Lösung behandeln -Kapitel für Sender und Empfänger hinzugefügt -Kapitel für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
2015-02-05 Weiter an der Doku gearbeitet. Sender mit Komparatorschaltung erklärt.
2015-02-06 Doku komplett umstrukturiert. Möglicherweise können Kapitel von Sender und Empfänger noch zusammengefasst werden.
2015-02-09 Weitere Push-Pull-Schaltung hinzugefügt. Verwendet NPN und PNP in Endstufe, dadurch wird kurzzeitiges gleichzeitiges Öffnen vermieden. -> Es fließt weniger Strom, Spannungsquelle wird nicht unnötig b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
2015-02-10 2. Kapitel Projektübersicht weiter geschrieben. Übersicht, Architektur und einzelne Komponenten beschrieben.
2015-02-17 FINALLY! Gegentakt-Ausgangsstufe mit MOSFETS umgesetzt. Funktioniert perfekt.
2015-02-18 Sender (Bipolar) V1 überarbeitet und V2 rausgeschmissen. Ist nun als Alternativlösung zu MOSFET-Ansatz denkbar.
2015-02-18 Kapitel 3 (Sender) und 4 (Empfänger) in neues Kapitel Schaltungen verschoben.
2015-02-19 Kapitel Senderschaltung weiter geschrieben. Transistor-Teil und Einleitung vorerst fertig, Gegentaktstufe in Arbeit.
2015-02-20 Schaltung für Verteilerplatine hinzugefügt. Signalwandlung für SPI von 3.3V (RPI) -> 5V (AVR) noch notwendig. Websitequellen geupdated.
    [Mikrocontroller.sch, RaspberryPI.sch, verteilerplatine.sch]
2015-02-22 Schaltplan und Platinenentwurf von Verteilerplatine fertig.
    [Mikrocontroller.sch, RaspberryPI.sch, verteilerplatine.kicad_pcb, verteilerplatine.sch]
2015-03-18 Layout für überarbeitete Prototyp-Platine fast fertig.
    [Display.sch, Empfänger.sch, Mikrocontroller.sch, Sender.sch, prototyp_platine.kicad_pcb, prototyp_platine.sch]
2015-03-21 Schema fertig.
    [Display.sch, Empfänger.sch, Mikrocontroller.sch, Sender.sch, prototyp_platine.kicad_pcb, prototyp_platine.sch]
2015-04-01 Kleine Änderungen am Schaltplan und Layout. Firmware: Dateien für Display (7-Segment Anzeige) hinzugefügt.
    [Display.sch, Empfänger.sch, Mikrocontroller.sch, Sender.sch, prototyp_platine.kicad_pcb, prototyp_platine.sch]
2015-04-16 Update von Firmware und Schaltungen.
    [Display.sch, Empfänger.sch, Mikrocontroller.sch, Sender.sch, prototyp_platine.kicad_pcb, prototyp_platine.sch]
2015-05-04 Erster Entwurf von Endplatine hinzugefügt.
    [Display.sch, Empfänger.sch, Mikrocontroller.sch, Sender.sch, endplatine.sch]
2015-05-04 Reihenfolge geändert..
    [Empfänger.sch, Mikrocontroller.sch, Sender.sch, endplatine.sch]
2015-05-07 Empfängerschaltung vervollständigt. Tests wurden vertagt.
    [Empfänger.sch, Mikrocontroller.sch, Sender.sch, endplatine.sch]
2015-05-11 Schaltung für Endplatine fertig. Makefile für neuen Programmer angepasst.
    [Empfänger.sch, Mikrocontroller.sch, Sender.sch, endplatine.sch]
2015-05-12 Platinenentwurf für Endplatine hinzugefügt und fertig gestellt.
    [Empfänger.sch, Mikrocontroller.sch, Sender.sch, endplatine.kicad_pcb, endplatine.sch]
2015-05-13 Firmware für Endplatine angefangen, kleine Änderungen am Platinenentwurf.
    [endplatine.kicad_pcb]
2015-05-15 Firmware update, Transistor in Schaltung geändert.
    [Empfänger.sch, Mikrocontroller.sch, Sender.sch, endplatine.sch]
2015-05-15 platinenlayout an überarbeiteten Verstärker angepasst. Wenn das nicht klappt -> Extra TreiberIC o.ä.
    [endplatine.kicad_pcb]
2015-06-03 Update der Doku. Bild der Gegentaktstufe hinzugefügt.
2015-06-08 Doku-Update von Marina.
    [Display.sch, Empfänger.sch, Mikrocontroller.sch, Sender.sch, prototyp_platine.sch]
2015-06-09 Doku und Windmühlen.
2015-06-11 Firmware: Main überarbeitet, unterscheidung der Platinen in Software möglich, Pulsierende LEDs per SoftPWM.
2015-06-12 Doku-Update: Firmware mit einzelnen Komponenten beschrieben, Berechnungen für Genauigkeit und Reichweite. Kapitel über Schaltungen (Sender) bearbeitet.
2015-06-12 Time of Flight Interface neu geschrieben, Logik in Main überarbeitet. Unvollständig und verbuggt.
2015-06-12 Bugs gefixt, code überarbeitet.
    [display.c, display.h, main.c, protocol.h, time_of_flight.c, time_of_flight.h]
2015-06-13 TWI funktioniert! Neue lib eingesetzt, Empfangen und Senden per Interrupt.
2015-06-13 Abstandsmessung zwischen den Sensoren nun möglich.
2015-06-14 Kleine Firmwareänderung: Controller beendet Zustand Warten (bei Abstandsmessung untereinander), wenn Kommando Connect/Disconnect gesendet wird.
2015-06-15 Alternative Berechnung des Abstands ohne Gleitkommazahlen.
2015-06-15 Änderungen am Code rückgängig gemacht: Takt ist so ungenau, dass exakte Schallgeschwindigkeit die Genauigkeit eher verschlechtert.
2015-06-20 Firmware überarbeitet, I2C-Bug gefixt und an Raspberry-Pi angepasst (Bit 8 wird durch Bug im Chip abgeschnitten).
    [main.c, twi_slave.c, twi_slave.h]
2015-07-05 Beschriftung der Oszi-Bilder
2015-07-06 Letzen Änderungen an der Doku. Quellen, Text, Bode-Diagramm und Firmware-Ablaufdiagramm.
2015-07-06 Anpassung der Verteiler-Platine (Verbindung der Trigger-Leitung)
    [Mikrocontroller.sch, RaspberryPI.sch, verteilerplatine.kicad_pcb, verteilerplatine.sch]
2015-07-07 Kleine Korrekturen an der Doku (Rechtschreibung, Referenze, Formel)
